nachocarballeda/gclass_amplifier/README.md

# gclass_amplifier
Diseño de un amplificador clase G para la materia Circuitos Electronicos 2. FIUBA
