nachocarballeda/gclass_amplifier/informe/caratula.tex

\begin{titlepage}

\thispagestyle{empty}

\begin{center}

\\[0.1cm]
\textsc{\universidad}\\[0.2cm]
\large{\textsc{\facultad}}\\[0.2cm]

\end{center}

\vfill

\begin{center}
\underline{\Large{\nombreMateria\, (\codigoMateria)}}
\end{center}

\vfill
\begin{center}

\end{center}
\vfill

\begin{center}
\Huge{\textsc{ \tituloTP }}\\[.5cm]
	\begin{figure}[H]
		\centering
		%\inclugraphics[width=.5\textwidth]{bessel}
	\end{figure}\HRule \\[0.1cm]
\Huge{\textbf{\descripcionTP}}\\[0.01cm]
\HRule\\[0.3cm]
\end{center}

\vfill

\begin{tabbing}
	FECHA: \today\\
\\
	INTEGRANTES:\hspace{-1cm}\=\+\hspace{1cm}\=\hspace{6cm}\=\\
% 		Gomez, Cristian	\>\>- \#89968\\
%			\>\footnotesize{$<$crisgvenezia@gmail.com$>$}\\
		Pollitzer, Ivan Gustavo	\>\>- \#22922\\
			\>\footnotesize{$<$igpollitzer@gmail.com$>$}\\
		Carballeda, Ignacio	\>\>- \#91646\\
			\>\footnotesize{$<$carballeda.ignacio@gmail.com$>$}\\
		Marques Rojo, Rui Alejandro\>\>- \#85748\\
			\>\footnotesize{$<$rui.rojo@gmail.com$>$}\\			

\end{tabbing}

\begin{flushleft} \large
\emph{Docentes:}\\[.2cm]
\end{flushleft}
\begin{tabbing}
\docentes\\[.5cm]
\end{tabbing}

\vfill

\hrule
\vspace{0.2cm}

\noindent\small{\codigoMateria\, --- \nombreMateria \hfill \facultad}

\end{titlepage}
