nachocarballeda/gclass_amplifier/informe/img/diagramabloque.pdf

Optimización
de recorrido
Inicio | Ruta actual
