nachocarballeda/gclass_amplifier/informe/avance/img/sim/distorsion-barrido.pdf

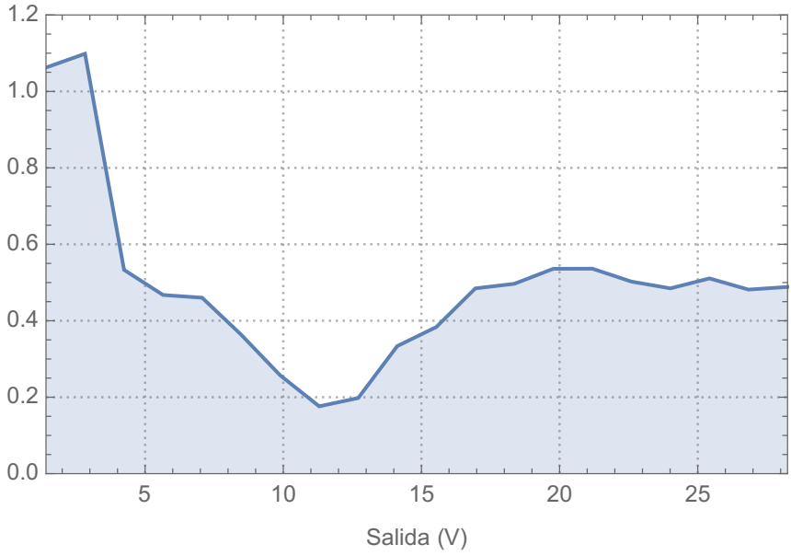
[picture p110: figure]
Salida

## THD (%)
