nachocarballeda/gclass_amplifier/informe/banco/amplificador.png

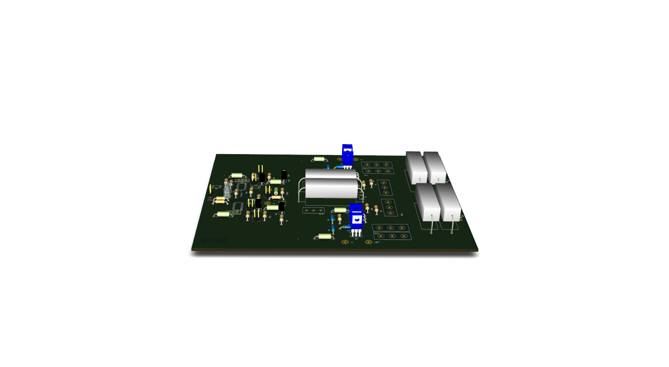
informe/banco/amplificador.png
