nachocarballeda/gclass_amplifier/informe/banco/fasttrack.jpg

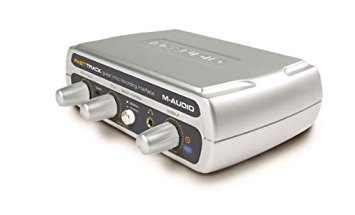
informe/banco/fasttrack.jpg
