nachocarballeda/gclass_amplifier/informe/banco/fuente.jpg

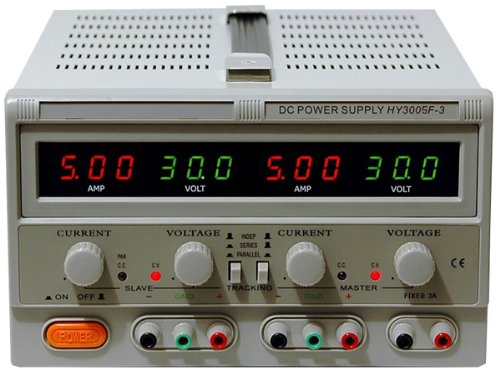
informe/banco/fuente.jpg
