nachocarballeda/gclass_amplifier/informe/banco/gen.jpg

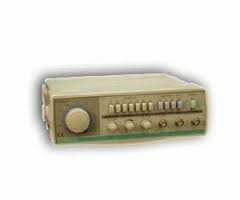
informe/banco/gen.jpg
