nachocarballeda/gclass_amplifier/informe/banco/mult-tip.png

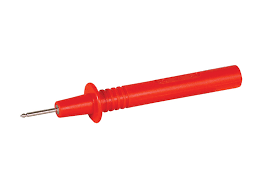
informe/banco/mult-tip.png
