nachocarballeda/gclass_amplifier/informe/banco/mult.jpg

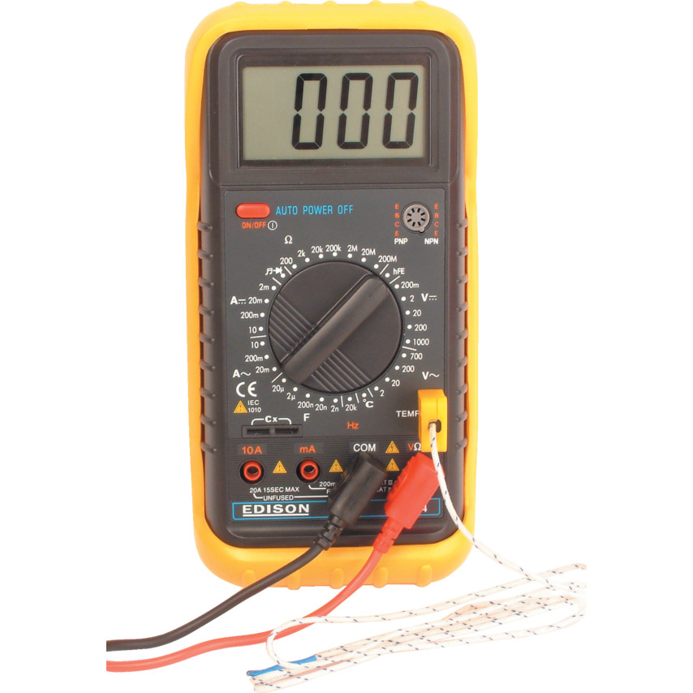
informe/banco/mult.jpg
