nachocarballeda/gclass_amplifier/informe/banco/osc-probe.jpg

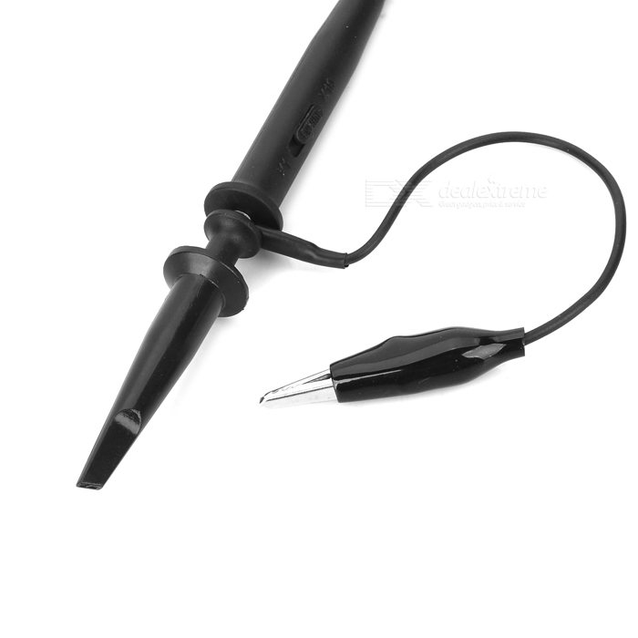
informe/banco/osc-probe.jpg
