nachocarballeda/gclass_amplifier/informe/banco/oscil-atten.jpg

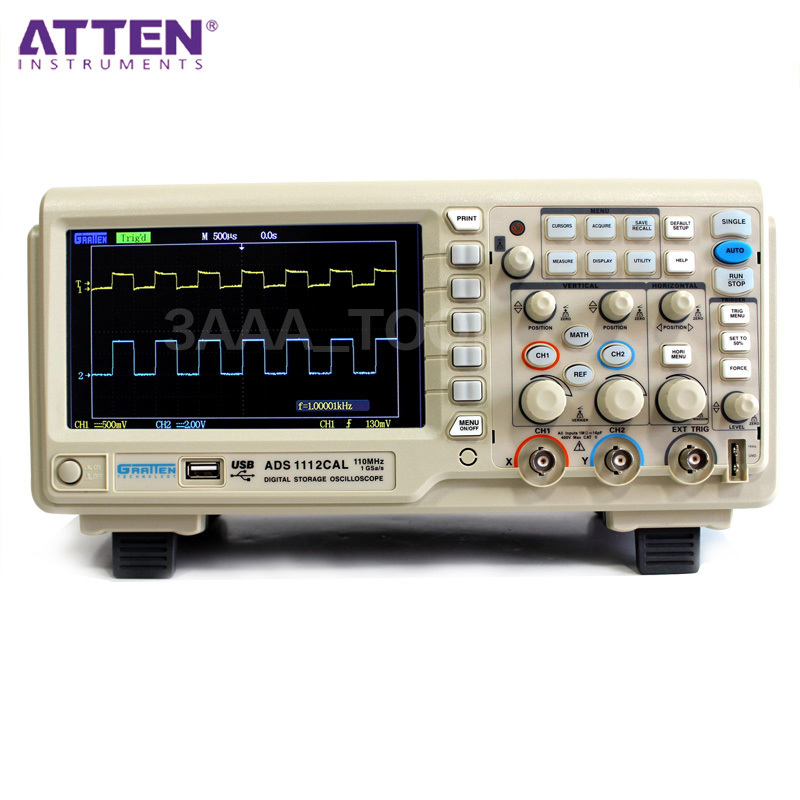
informe/banco/oscil-atten.jpg
