nachocarballeda/gclass_amplifier/informe/banco/osciloscopio.jpg

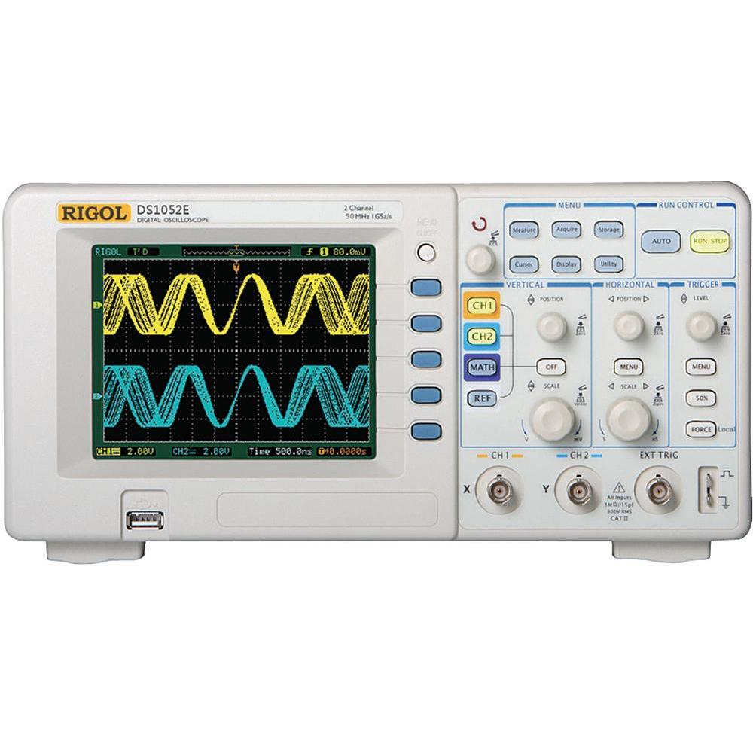
informe/banco/osciloscopio.jpg
