nachocarballeda/gclass_amplifier/informe/banco/pote.jpg

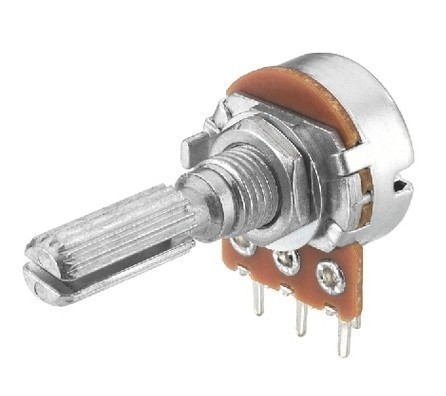
informe/banco/pote.jpg
