nachocarballeda/gclass_amplifier/informe/banco/res.jpg

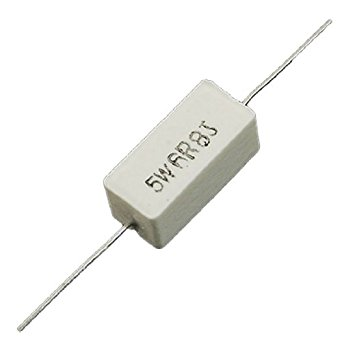
informe/banco/res.jpg
