nachocarballeda/gclass_amplifier/informe/banco/resS.JPG

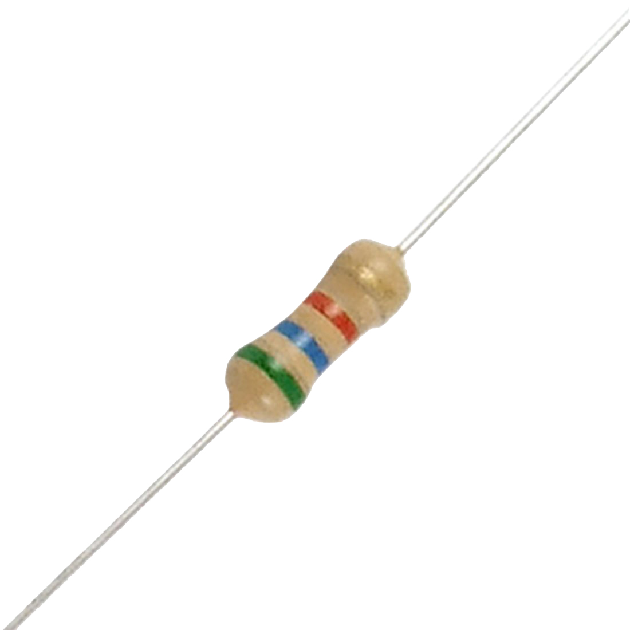
informe/banco/resS.JPG
