nachocarballeda/gclass_amplifier/informe/banco/tip2.jpeg

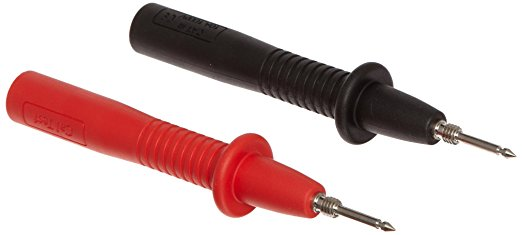
informe/banco/tip2.jpeg
