nachocarballeda/gclass_amplifier/informe/banco/transf.jpg

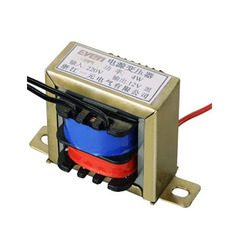
informe/banco/transf.jpg
