nachocarballeda/gclass_amplifier/informe/img/ampliA.png

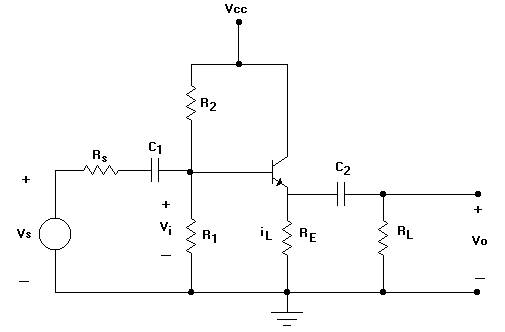
informe/img/ampliA.png
