nachocarballeda/gclass_amplifier/informe/img/ampliC.png

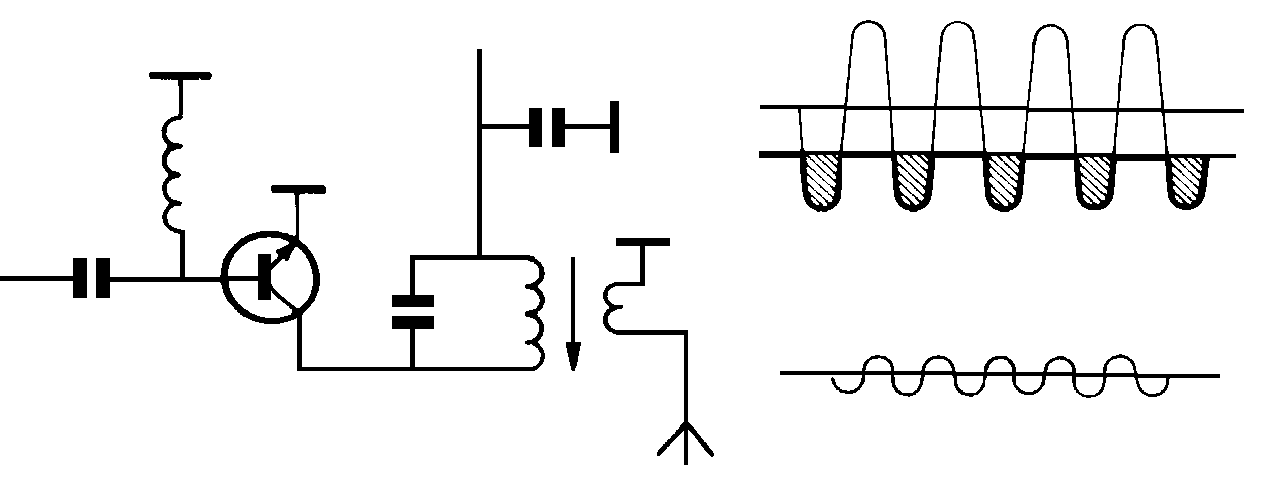
informe/img/ampliC.png
