nachocarballeda/gclass_amplifier/informe/img/ampliD.png

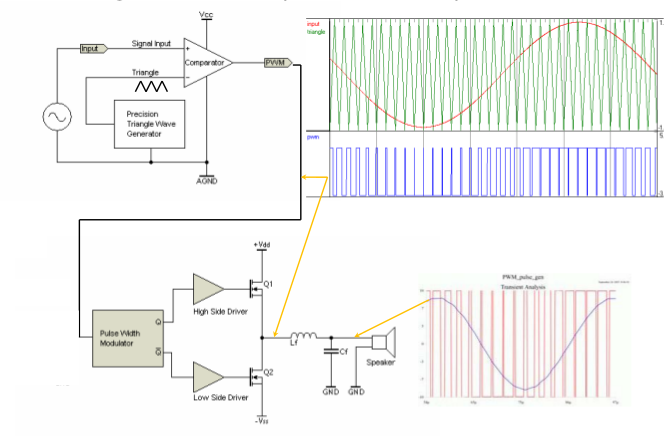
informe/img/ampliD.png
