nachocarballeda/gclass_amplifier/informe/img/circuito_propuesto.PNG

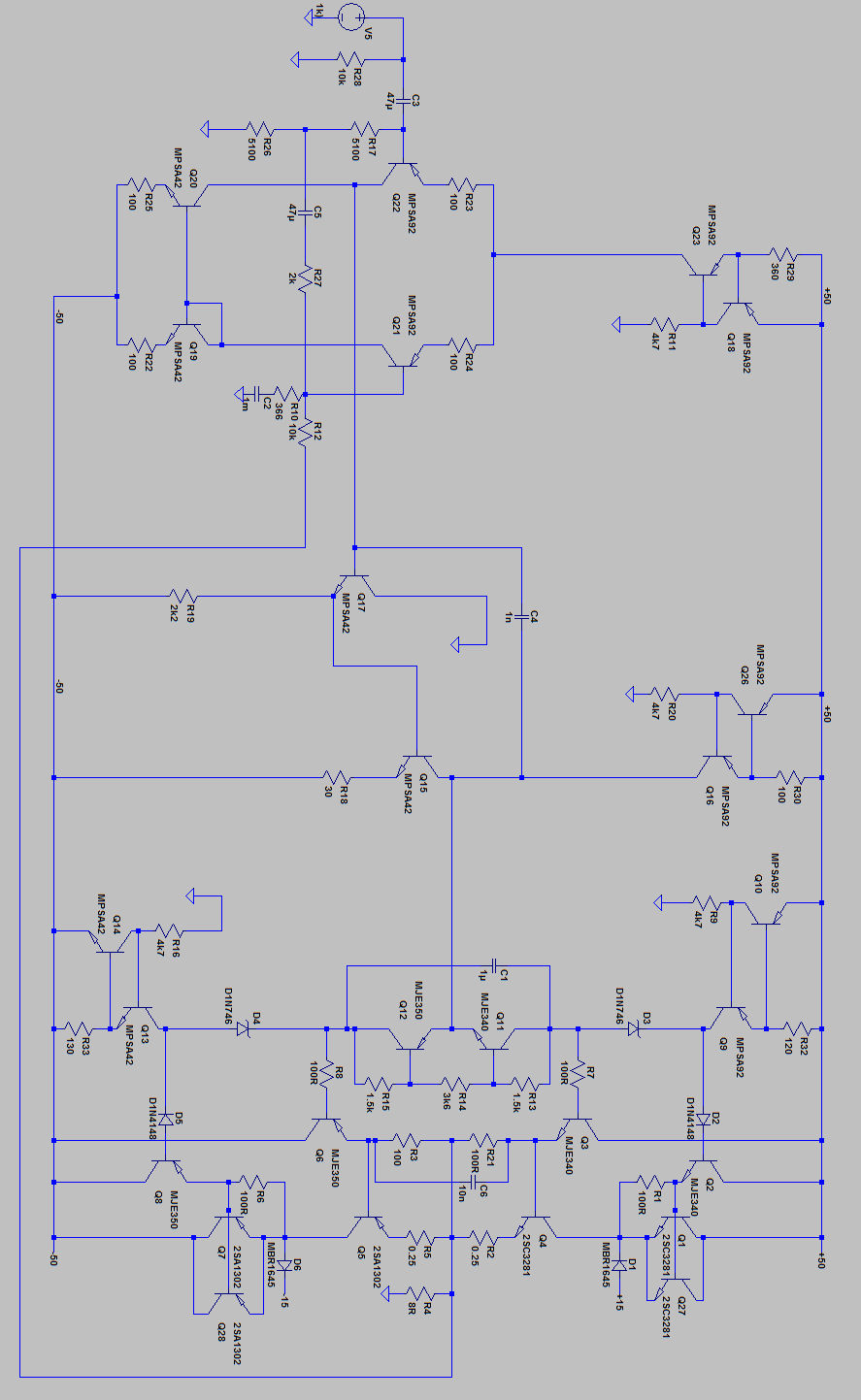
informe/img/circuito_propuesto.PNG
