nachocarballeda/gclass_amplifier/informe/img/fft.PNG

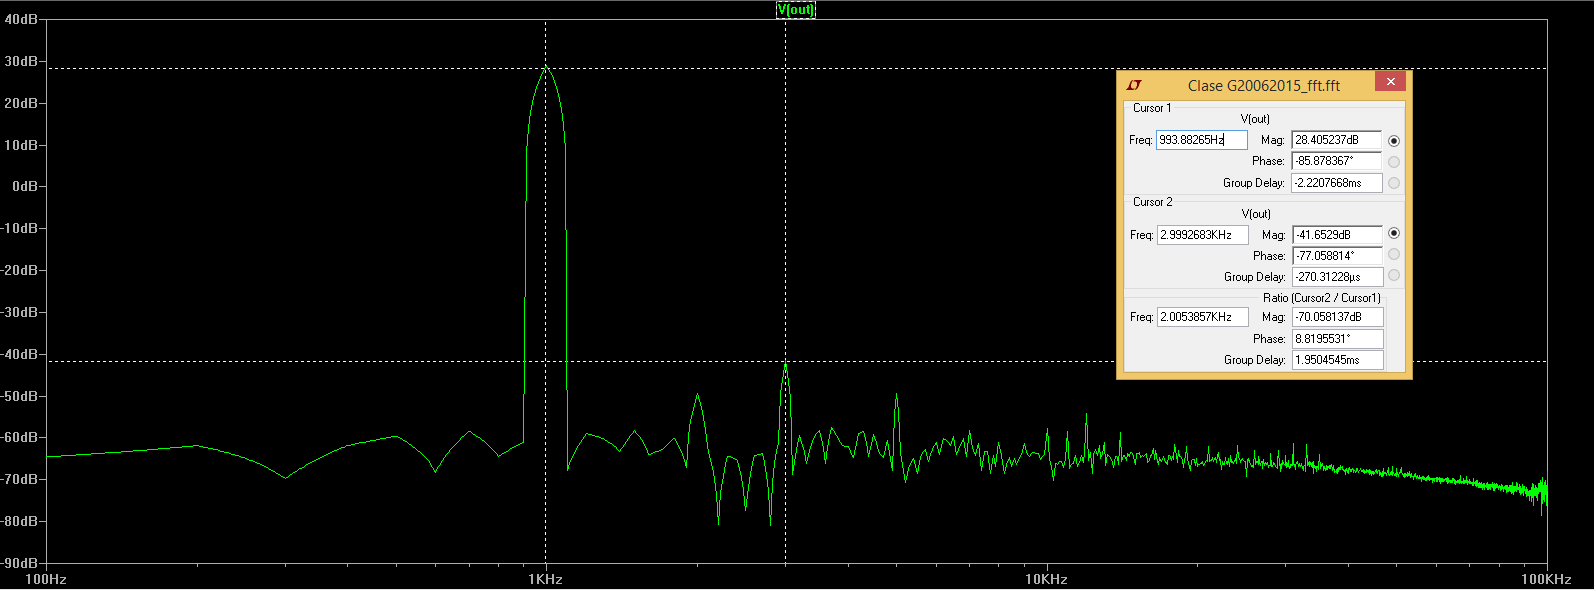
informe/img/fft.PNG
