nachocarballeda/gclass_amplifier/informe/img/img1.png

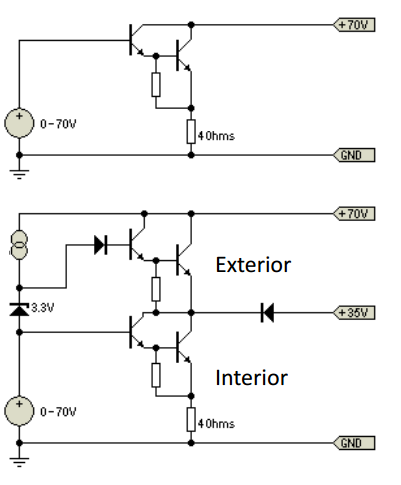
informe/img/img1.png
