nachocarballeda/gclass_amplifier/informe/img/img2.png

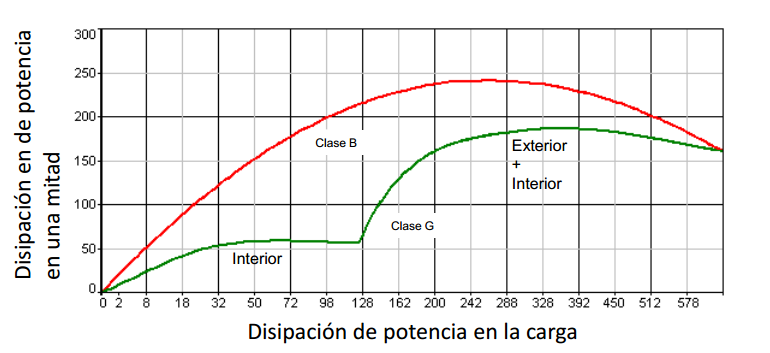
informe/img/img2.png
