nachocarballeda/gclass_amplifier/informe/img/mjes-power.png

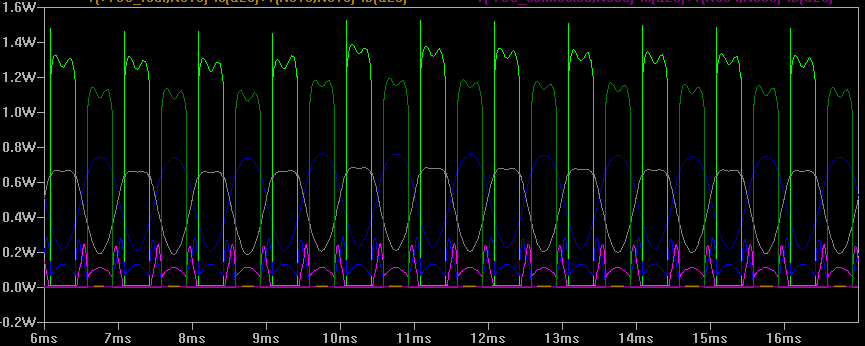
informe/img/mjes-power.png
