nachocarballeda/gclass_amplifier/informe/img/polarizacion.PNG

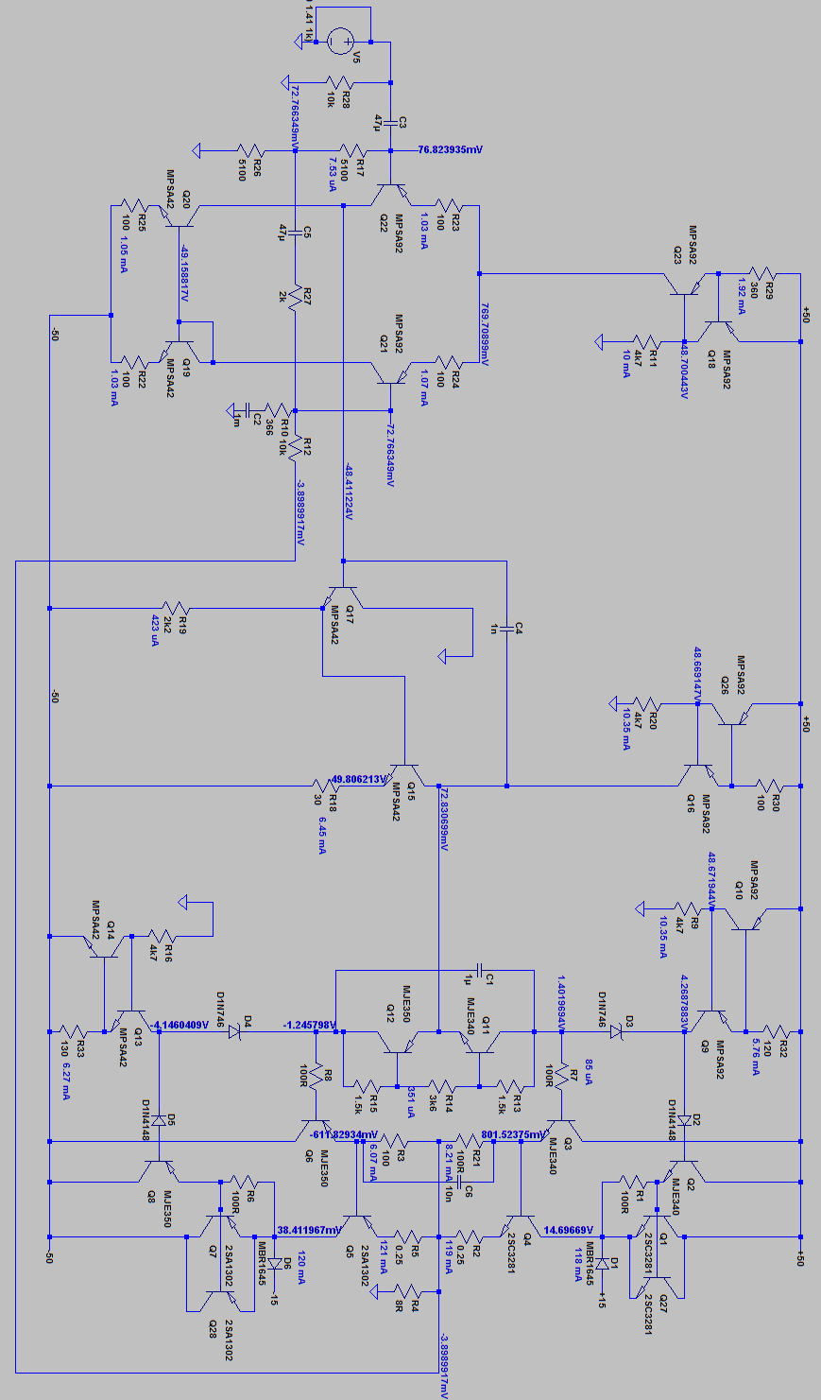
informe/img/polarizacion.PNG
