nachocarballeda/gclass_amplifier/informe/img/sim/circuito-doble-par-bode-10k.png

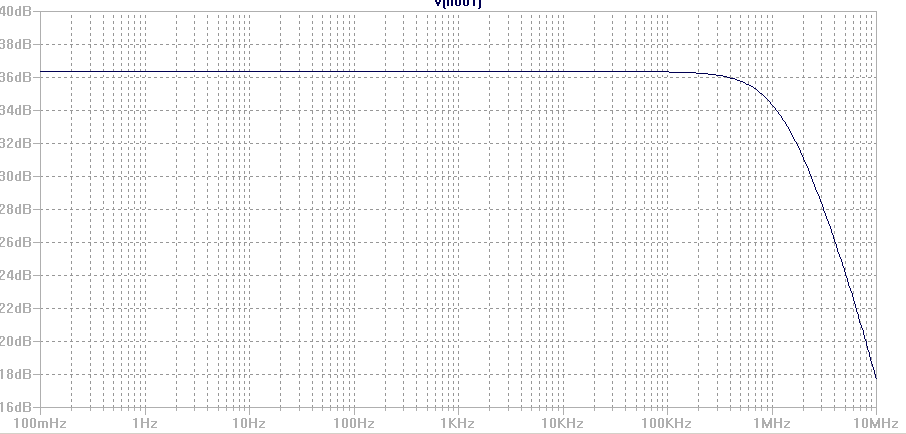
informe/img/sim/circuito-doble-par-bode-10k.png
