nachocarballeda/gclass_amplifier/informe/img/sim/circuito-par-cascode-bode-10k.png

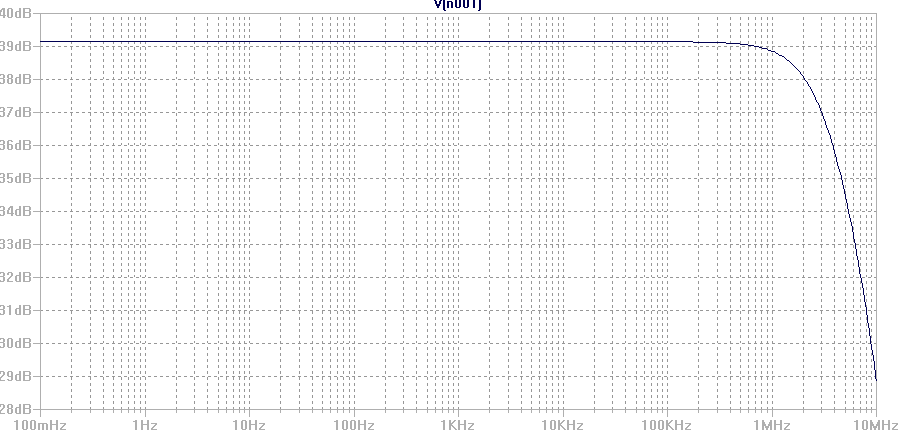
informe/img/sim/circuito-par-cascode-bode-10k.png
