nachocarballeda/gclass_amplifier/informe/img/sim/circuito-par-cascode.png

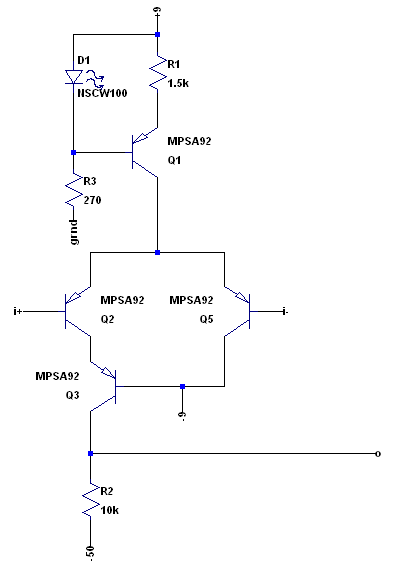
informe/img/sim/circuito-par-cascode.png
