nachocarballeda/gclass_amplifier/informe/img/sim/circuito-r_out.png

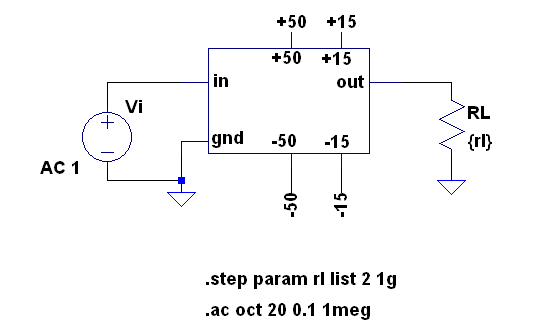
informe/img/sim/circuito-r_out.png
