nachocarballeda/gclass_amplifier/informe/img/slew_rate.PNG

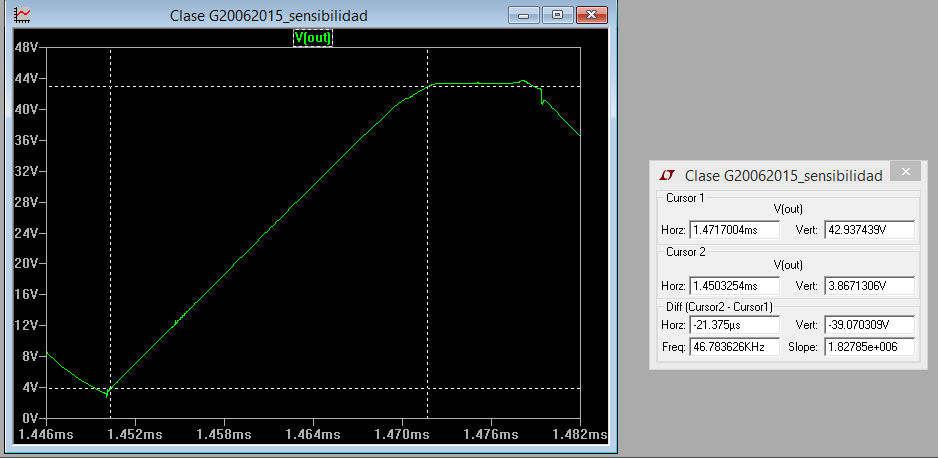
informe/img/slew_rate.PNG
