nachocarballeda/gclass_amplifier/informe/img/zd3.jpg

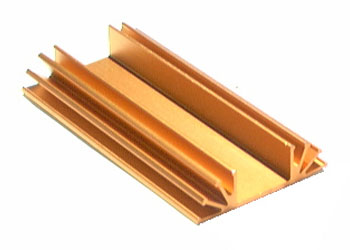
informe/img/zd3.jpg
