nachocarballeda/gclass_amplifier/informe/mediciones/includes/slew.jpg

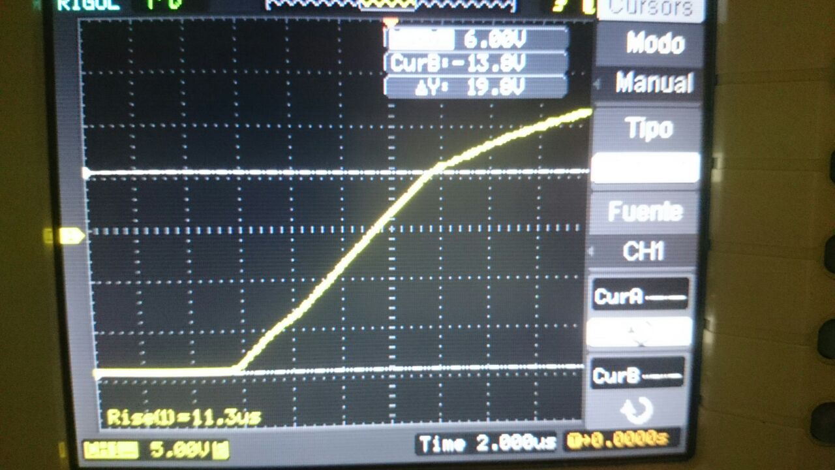
informe/mediciones/includes/slew.jpg
