nachocarballeda/gclass_amplifier/(list of files, cad)

Other CAD files:
pcb/PCB_3d_model.fcstd
