nachocarballeda/gclass_amplifier/sims/pruebas/pruebas-rui/plots/test.txt

Freq.	-V(n013)/I(V5)
1.00000000000000e-001	(9.09516936097004e+001dB,-7.36975448381585e+001°)
1.03526492384138e-001	(9.06752023476581e+001dB,-7.31548731468580e+001°)
1.07177346253629e-001	(9.04003183900117e+001dB,-7.25963432233475e+001°)
1.10956947206785e-001	(9.01271363469511e+001dB,-7.20217111976893e+001°)
1.14869835499704e-001	(8.98557549782021e+001dB,-7.14307518212159e+001°)
1.18920711500272e-001	(8.95862771869094e+001dB,-7.08232609541542e+001°)
1.23114441334492e-001	(8.93188099845264e+001dB,-7.01990581782132e+001°)
1.27456062731926e-001	(8.90534644232138e+001dB,-6.95579895235196e+001°)
1.31950791077289e-001	(8.87903554921842e+001dB,-6.88999302959567e+001°)
1.36604025675440e-001	(8.85296019744376e+001dB,-6.82247879873335e+001°)
1.41421356237310e-001	(8.82713262604010e+001dB,-6.75325052469033e+001°)
1.46408569594563e-001	(8.80156541151512e+001dB,-6.68230628886239e+001°)
1.51571656651040e-001	(8.77627143961546e+001dB,-6.60964829042705e+001°)
1.56916819579350e-001	(8.75126387188291e+001dB,-6.53528314481742e+001°)
1.62450479271247e-001	(8.72655610677190e+001dB,-6.45922217550635e+001°)
1.68179283050743e-001	(8.70216173516894e+001dB,-6.38148169483837e+001°)
1.74110112659225e-001	(8.67809449022943e+001dB,-6.30208326926917e+001°)
1.80250092522166e-001	(8.65436819153490e+001dB,-6.22105396404686e+001°)
1.86606598307362e-001	(8.63099668367490e+001dB,-6.13842656211126e+001°)
1.93187265784969e-001	(8.60799376946976e+001dB,-6.05423975181923e+001°)
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
9.30774334994442e+005	(6.43486961676853e+001dB,-1.06168323063527e+002°)
9.63598021031530e+005	(6.38134784302734e+001dB,-1.05341768368432e+002°)
9.97579231856909e+005	(6.32878423705015e+001dB,-1.04423265743424e+002°)
1.00000000000000e+006	(6.32514538110982e+001dB,-1.04355679441212e+002°)
