nachocarballeda/gclass_amplifier/(threads)

Thread 4 (2015-12-06):

La distorsión daba para la mierda

anojo, 2015-12-06:
Bueno, era culpa mía nomás.

Simular pocos períodos jode la simulación de la distorsión, pero también erra si le ponés un timestep máximo alto (o lo dejás en automático). Alguno de uds había sugerido eso el otro día. Bueno, tengo el agrado de avisarles que la distorsión volvió a estar en el orden de 0.05%.

Igual todavía hay que mejorarla.

Closed 2015-12-12.

Thread 5 (2015-12-06):

Especificaciones

anojo, 2015-12-06:
Fede dijo que hay que especificar también un par de cosas más. ¿Qué valores les parecen? Por ahora mando esto:

* Ancho de banda de potencia: >30kHz
* Ancho de banda: 10Hz-30kHz
* Factor de amortiguamiento: >200

Fede no dijo pero seguramente haya que especificar igual:

* Margen de  fase
* Margen de ganancia
* Eficiencia
* SNR
* Otros tipos de distorsión que no sean THD?

anojo, 2015-12-09:
¡Especificar SNR y eficiencia!

Closed 2015-12-12.

Thread 7 (2015-12-09):

Cambios del circuito

anojo, 2015-12-09:
¿Qué mierda falta cambiar así rápido paralelizamos las tareas?

* Capaz el bootstrap
* Lo que mandó Fede para la primera etapa
* ¿Cargas activas vs resistencia en el VAS?
* ¿Fuente conmutada diseñada?

anojo, 2015-12-09:
Modelos de transistor de etapa de entrada??? Chequear early

Closed 2015-12-12.

Thread 10 (2015-12-14):

Chamullos que puede estar bueno tirar en el informe

anojo, 2015-12-14:
Tiremos en este issue esas ideas aisladas. Ejemplo.
- Importancia de la tensión de early en los transistores del VAS, porque hacen de carga activa el uno del otro

anojo, 2015-12-14:
* Importancia del beta de todos los transistores del VAS para que reflejen mucha resistencia y se fije mejor la tensión. Principalmente del del buffer, porque si el del EC es muy grande, la corriente de polarización del buffer se vuelve porquería. Pero, no veo que eso sea un problema, no sé. ¿Capaz estás dejando nodos de alta impedancia y eso jode al ruido? Tengo bastante poco fresco el tema del ruido

anojo, 2015-12-14:
Compensación. Algún chamullo del cero del realimentador y de Miller, y del compromiso con el slew rate. El slew rate todavía no lo entiendo bien, algún día miraré de vuelta esa clase de Bertuccio

anojo, 2015-12-14:
La R_E del EC del VAS. Realimentación para estabilizar, blabla, pero no muy alta porque, además de perder amplificación, roba excursión a la salida

anojo, 2015-12-14:
A la salida, anchas, gordas y cortas las cosas, por las altas corrientes, y por la baja resistencia de salida (gracias a la realimentación) que hay que mantener para que se mantenga un buen factor de amortiguamiente.

Closed 2017-11-03.

Thread 11 (2015-12-14):

Presets

anojo, 2015-12-14:
¿En las resistencias de los leds? Polarizan todo el circuito

nachocarballeda, 2015-12-17:
??? no entendi

anojo, 2015-12-20:
@nachocarballeda Iván me había preguntado dónde podía convenir poner presets para las resistencias de valor sensible. Después dijo que quede para después. Supuse que en las resistencias en los leds, que regulan las fuentes de corriente de la 1era etapa, pero no está definid.

anojo, 2015-12-22:
Me habían comentado que había pines en el PCB para probar cosas y que les viniero bárbaro el semestre pasado. ¿Dónde quedan esos pines en el circuito?

Closed 2017-11-03.

Thread 12 (2015-12-14):

Zobel

anojo, 2015-12-14:
Parece que sí era importante.
Según Douglas, 10 ohms y 0.1uF va bien siempre y fuck it.

anojo, 2015-12-16:
La escribe "ZoEbel" en el mail

igpollitzer, 2015-12-16:
Agregué la red de Zobel. Dejo este inconveniente abierto, por si quieren dejarlo hasta que lo agreguen en el informe. Sino, cierrenlo.

anojo, 2015-12-16:
Claro que queda abierto. No le consultamos a Fede, no lo agregamos en el circuito.

anojo, 2015-12-16:
Además, por loq ue veo en el circuito del clase G del Douglas, además de esa RC tiene un RL paralelo a la salida

anojo, 2015-12-16:
Aparentemente, es el RC lo que se llama Zobel. Y el LR es para "aislar al amplificador de capacidad de carga". "Un componente de 15-20 vueltas de diámetro 1 pultada debería funcionar bien. El valor de la inductancia no es para nada crítico para la estabilidad"

anojo, 2015-12-16:
El inductor tiene que ser de aire para tener menos distorsión. Los valores de L suelen andar en 1-7uH.

Closed 2015-12-22.

Thread 13 (2015-12-14):

Protecciones

anojo, 2015-12-14:
No van en el informe de aprobación. Pero, ¿cuáles ponemos?
- Contra mucha carga => mucha corriente a la salida.

anojo, 2015-12-20:
Ojo que no hagan bolsa la distorsión

Closed 2017-11-03.

Thread 15 (2015-12-14):

Cálculos y simulación de ganancia y polarización de cada etapa

anojo, 2015-12-14:
Paja. Será bien resumido. "anojo" puede hacer el chamullo de las primeras 2 etapas, pero la tercera no.

anojo, 2015-12-20:
Lo principal está. Faltaría un poco, en particular de la 3ra etapa

Closed 2017-11-03.

Thread 16 (2015-12-14):

Cálculo y justificación de las decisiones de diseño

anojo, 2015-12-14:
Valores de componentes, tipos, tecnologías, subcircuitos, lablab.

nachocarballeda, 2015-12-17:
esto ya esta.. ¿le mando los datasheets de los "subcircuitos"  ??

anojo, 2015-12-17:
Meter los datasheets en el informe de avance sería demasiado,  jaja

nachocarballeda, 2015-12-17:
entonces cerramos esto?

anojo, 2015-12-17:
yo no lo cerraría, me parece que es uno de esos puntos donde mienrtas más mejor. Dejémoslo para lo último.

anojo, 2015-12-20:
Faltan, al menos, cuestiones de la etapa de salida (¿para qué es ese capacitorr? Una versus otra opción respecto de las resistencias en los emisores de los drivers de la parte interna. Chamullo diodo schohcsocohty, ...)

Closed 2015-12-22.

Thread 17 (2015-12-14):

Lista de componentes

anojo, 2015-12-14:
Tabla con

Nombre en el esquemático |  valor/modelo  | Tolerancia (?) | Potencia (?) | Tecnología/whatever

anojo, 2015-12-16:
Aclarar en dónde se usa SMD. Ver si hace falta incluir tooodo, disipadores etc

anojo, 2015-12-17:
¿Tolerancias?

nachocarballeda, 2015-12-17:
listo,agregadas tolerancias no entran mas columnas.

Closed 2015-12-17.

Thread 21 (2015-12-14):

Mejora mult de vbe

anojo, 2015-12-14:
Agregar resistores en los colectores, y sacar la tensión de ahí para que sea más plano el multiplicador

anojo, 2015-12-20:
Ver balance eficiencia-distorsión. También, frase sacada de contexto del Douglas en la parte de etapa de salida, la distorsión en modo AB es peor que en A y que en B. Huh??

Closed 2017-11-03.

Thread 9 (2015-12-14):

[PCB] Falta conector de entrada

nachocarballeda, 2015-12-14:
Necesitamos un buen plug hembra con carcaza anti ruido para la entrada de nuestro amplificador.

nachocarballeda, 2015-12-16:
Este issue nos chupa un huevo por ahora :D

Closed 2015-12-16.

Thread 23 (2015-12-16):

Especificaciones: Slew Rate

anojo, 2015-12-16:
"El valor de SR es apenas mayor que el mínimo necesario, respecto del que garantiza un ancho de banda de potencia de 20KHz con Vo pico 50V."

anojo, 2015-12-16:
¿por qué 50V si la máx excursión es 40V?

anojo, 2015-12-16:
¿Y porqué 20kHz si especificamos 30kHz?

anojo, 2015-12-16:
Nuestro límite, con 30kHz, y 40V, es de 7.5 V/us. Si tomamos los 50V que soñó Fede, queda 9.4V/us. La simulación nos da que tenemos 20V/us. Es gratis entonces subir la especificación hasta ese punto.

anojo, 2015-12-17:
Le puse 15 y chamullo

Closed 2015-12-17.

Thread 24 (2015-12-16):

Diseño general, etapa de salida

anojo, 2015-12-16:
"En la página 4 no hace falta hablar del clase D ya que eligieron la clase G."

anojo, 2015-12-16:
Ok, lo sacamos, pero. Ellos nos dijeron que pusiéramos cómo consideramos otras opciones de diseño dados los requerimientos de usuario.

Closed 2015-12-16.

Thread 25 (2015-12-16):

Resistencias de emisor

anojo, 2015-12-16:
Aclaración al circuito que tienen: conviene poner una resistencia entre el emisor de Q13 y +50V, de manera que el seguidor le presente una menor impedancia al emisor común. Es decir, se necesita que el Q13 tenga una mayor corriente que Q14. Lo mismo ocurre con el Q10 y Q9.

anojo, 2015-12-16:
Que necesita mayor corriente que la de Q14/beta, lo "sospechaba" aunque no entendía (y por eso hice el cambio igual, ya que lo había sugerido el propio Fede en la última reunión lo de desaparecer esas resistencias"). Pero, ¿mayor que Q14? ¿Seguro, por qué?

Closed 2015-12-17.

Thread 26 (2015-12-16):

Punto #9: mail Fede

anojo, 2015-12-16:
En la etapa de salida, cuando agregan las resistencias que les mencioné, no era para evitar el embalamiento térmico sino para que circule la mitad de corriente por cada transistor ya que Q11 y Q12 tienen un propósito.

Closed 2015-12-17.

Thread 27 (2015-12-16):

Punto #10: mail Fede

anojo, 2015-12-16:
Fíjense de revisar la Fig.4, ya que la distorsión no tiende a cero cuando baja la alimentación.

anojo, 2015-12-16:
Supongo que cuando dijo alimentación se refería a la tensión pico de salida. Y tiene razón, no debería achicarse tanto, con el crossovor y eso, al contrario. Yo lo reviso

Closed 2015-12-17.

Thread 31 (2015-12-16):

Punto #2: mail Fede

anojo, 2015-12-16:
Los análisis que hagan, deberían ser en base a los antecedentes que encontraron, es decir: plantear bloques o soluciones en base a circuitos modelos. También es conveniente que expliquen qué tipo de realimentación utilizan, es decir, qué se suma y qué se muestrea. Analicen el circuito como si fuera un Op.Amp. realimentado, viendo las Zin, las Zo, etc, todo tal cual lo vieron en la 1era parte de la materia, incluído el SR, la compensación etc.

anojo, 2015-12-16:
Lo desgloso en sus subpuntos

Closed 2015-12-16.

Thread 32 (2015-12-16):

Especificaciones: sensibilidad

anojo, 2015-12-16:
La sensibilidad debe especificarse a qué potencia - carga específica (pág 3)

anojo, 2015-12-16:
¿No se entiende que si especificamos que el ampli trabaja con 8 ohms, la sensibilidad y todo lo demás, por defecto, es con 8 orms de carga? Sigh

igpollitzer, 2015-12-16:
Suspirás en inglés? Es lo que hay, viejo, respetar la nomenclatura.

anojo, 2015-12-16:
Bueno, cambio 1V RMS a 1V RMS @ 8\Omega.  ¿Valdrá la pena también especificar en corto, o a 2/4 ohms?

Closed 2015-12-17.

Thread 33 (2015-12-16):

Realimentación

anojo, 2015-12-16:
Poner qué tipo de realimentación utilizan, es decir, qué se suma y qué se muestrea

anojo, 2015-12-16:
Ok, esto es factible. Mirar el circuito, ver todas las realimentaciones, globales y locales que se encuentren, que estén mencionadas ena lgna  parte del informe, y donde lo estén, que se mencione si son serie-paralelo (sumo tensión muestreo tensión), serie-serie (...), etc.

igpollitzer, 2015-12-16:
Yo asumo que la respuesta, es la del issue siguiente.

Closed 2015-12-17.

Thread 34 (2015-12-16):

Modelo como op-amp realimentado

anojo, 2015-12-16:
Analicen el circuito como si fuera un Op.Amp. realimentado, viendo las Zin, las Zo, etc, todo tal cual lo vieron en la 1era parte de la materia, incluído el SR, la compensación etc.

anojo, 2015-12-16:
Ok, no pusimos ningún diagrama con el triangulito realimentado. Pero slew rate, compensación, no estoy seguro de lo que quiere. ¿Ustedes?

igpollitzer, 2015-12-16:
asumo que quiere que hagamos el triangulito, con el cuadrado de realimentación abajo, midiendo tensión y sumando tensión (paralelo/serie) eso modifica las impedancias de entrada y salida. No se que es lo que quiere con el SR y la compensación, salvo que sea hacer Ivas x Cmiller.

anojo, 2015-12-16:
@igpollitzer pero el nodo de Miller está adentro del opamp, no veo cómo se puede mencionar con ese modelo

nachocarballeda, 2015-12-16:
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
Bob Cordell  - Designing Audio Power Amplifiers

igpollitzer, 2015-12-17:
Bueno, yo creo que esto ya está terminado. Hice el dibujito del opamp realimentado, hice el gráfico de Bode compensado, y el cálculo del Slew Rate. Todo Bertu-Style.

Closed 2015-12-18.

Thread 35 (2015-12-16):

Punto #2.5: mail Fede

anojo, 2015-12-16:
Los análisis que hagan, deberían ser en base a los antecedentes que encontraron, es decir: plantear bloques o soluciones en base a circuitos modelos.

anojo, 2015-12-16:
Huh?

nachocarballeda, 2015-12-16:
Creo que quiere decir que si usas un ampli doble diferencial le expliques porque (esto se hizo), y 2doble le 2Vbe le expliques porque , y todo asi diciendo de donde sacaste la idea.

Closed 2015-12-18.

Thread 36 (2015-12-16):

Cosa general pero "NO MENOS IMPORTANTE"

anojo, 2015-12-16:
Antes que nada, y no menos importante, traten de explicar el Informe como si se lo fueran a dar a alguien que lo quiere armar. Es decir, explicando por qué está tal etapa y/o componente, con su respectivo valor, pero de forma concreta.

Closed 2017-11-03.

Thread 38 (2015-12-17):

Antecedentes

anojo, 2015-12-17:
Ok, pero agreguen circuitos, notas de aplicación y otros esquemas demostrando que buscaron antecedentes de un Amp. Clase G

nachocarballeda, 2015-12-17:
Ok, voy a agregar el clase G del Douglas Self y buscar algun comercial

anojo, 2015-12-17:
El "buscar algún comercial" quedó inconcluso, ¿no?

Closed 2017-11-03.

Thread 40 (2015-12-20):

Qué transistores para la 2da etapa

anojo, 2015-12-20:
¿Los que están u otros? Los que están, según los modelos de LTSpice, tiene la desventaja de que
- No son muy simétricos entre sí los NPN de los PNP
- Tienen  tensión de Early baja y por eso son "mala carga" el uno del otro. Esto sólo importaría para los EC. Anojo tiene que simular para saber cuánto importa.
- Quizá, un beta mejor estabilizaría un poco más la polarización. No me suena que esto sea importante.

nachocarballeda, 2016-03-15:
Por ahora en la segundo etapa tenemos MPSA42 (NPN) y MPSA92 (PNP)
No entiendo eso de que "no son muy simetricos" , entiendo que uno es el complemento del otro.
El VCE es 300V  en ambos, ¿esto es poco?

Closed 2017-11-03.

Thread 41 (2015-12-20):

Mejorar PCB

anojo, 2015-12-20:

anojo, 2015-12-22:
¿Cómo se arma posta el tema de las redes de salida, zobel y la otra, con el inductor loco de 1 pulgada de diámetro?

nachocarballeda, 2015-12-22:
@anojo Con alambre, lo dice en el Douglas S.

anojo, 2015-12-22:
@nachocarballeda O sea, nada que ver con el PCB, ¿no?

Closed 2017-11-03.

Thread 42 (2015-12-20):

¿Oscilación en el semiciclo?

anojo, 2015-12-20:
No parece que nos pase en nuestro circuito, pero sí en alguna de las pruebas que hicimos. Cuando aparece, sólo aparece cuando simulás bien lento. Tiene que ver con compensaciones en la tercera etapa, cosas mal compensadas para ciertas amplitudes en cierto semiciclo. No sé cómo se probaría bien bien. Sería una buena consulta a Bertuccio por mail. Probé algo que más o menos funciona, creo, pero no sé cuán bien está: agregué una fuente de "offset" en serie con Rin de 10k, y otra de "offset*28.2..." en serie con los 10k del realimentador. Después, haciendo bodes para distintos "offsets" se ven cosas interesantes y, efectivamente, mostraba que estaba mal compensado en el semiciclo negativo en un caso donde oscilaba.

anojo, 2015-12-22:
Al menos meterlo en el informe. Consultar sobre cómo simular, etc

Closed 2017-11-03.

Thread 44 (2015-12-22):

Modelos transistores 1era etapa

anojo, 2015-12-22:
Encontrar/inventar modelo de transistor para la 1era etapa. Si lo mejor que podés encontrar en un subcircuito, y no sabés cómo hacerlo funcionar en ltspice avisá, que para mi fue prueba y error

nachocarballeda, 2016-02-12:
Los transistores a utilizar en la etapa de entrada son
MMPQ2907A (PNP)
MMPQ2222A (NPN)

Spice Model [http://hep.fi.infn.it/PAMELA/pdf/FFB2907A.pdf]
PNP (Is=650.6E-18 Xti=3 Eg=1.11 Vaf=115.7 Bf=231.7 Ne=1.829 Ise=54.81f Ikf=1.079 Xtb=1.5 Br=3.563 Nc=2
Isc=0 Ikr=0 Rc=.715 Cjc=14.76p Mjc=.5383 Vjc=.75 Fc=.5 Cje=19.82p Mje=.3357 Vje=.75 Tr=111.3n Tf=603.7p
Itf=.65 Vtf=5 Xtf=1.7 Rb=10)

Spice Model [http://www.farnell.com/datasheets/172298.pdf]
NPN (Is=14.34f Xti=3 Eg=1.11 Vaf=74.03 Bf=255.9 Ne=1.307 Ise=14.34f Ikf=.2847 Xtb=1.5 Br=6.092 Nc=2 Isc=0
Ikr=0 Rc=1 Cjc=7.306p Mjc=.3416 Vjc=.75 Fc=.5 Cje=22.01p Mje=.377 Vje=.75 Tr=46.91n Tf=411.1p Itf=.6
Vtf=1.7 Xtf=3 Rb=10)

nachocarballeda, 2016-03-15:
Done.

Closed 2016-03-15.

Thread 45 (2015-12-22):

Análisis etapa de salida

anojo, 2015-12-22:
Ver en el Douglas u otros lados, para qué está ese capacitor en a la etapa de salida. También, si había alternativas respecto de otras cositas, como esas resistencias entre los emisores de los drivers internos (en la parte de "etapa de salida" del clase B del libro creo que había cosas). Ir leyendo eso y chamullando en el informe, sobre para qué está cada cosa, y cambiando el circuito si algo resulta ser indefendiblemente mejor. Chamullo diodo Schotscscsy... Lo que se vaya pensando, se anota así ya va al informe.

anojo, 2015-12-22:
(Anojo tb va a ir dando una mano en estas cosas)

anojo, 2015-12-22:
¿Douglas dice que AB distorsiona más que B? Huh?

Closed 2017-11-03.

Thread 47 (2015-12-22):

R_out y amortiguamiento

anojo, 2015-12-22:
Ver R_out teniendo en cuenta el RL de la salida, y si es necesario la posible R serie del L y los cables.

anojo, 2015-12-22:
Esto queda para después, no es necesario para empezar a armar creo. A menos que el factor de amortiguamiento quede muy choto, pero no creo, qué se yo

Closed 2017-11-03.
