nachocarballeda/gclass_amplifier/informe/export_kicad.pdf

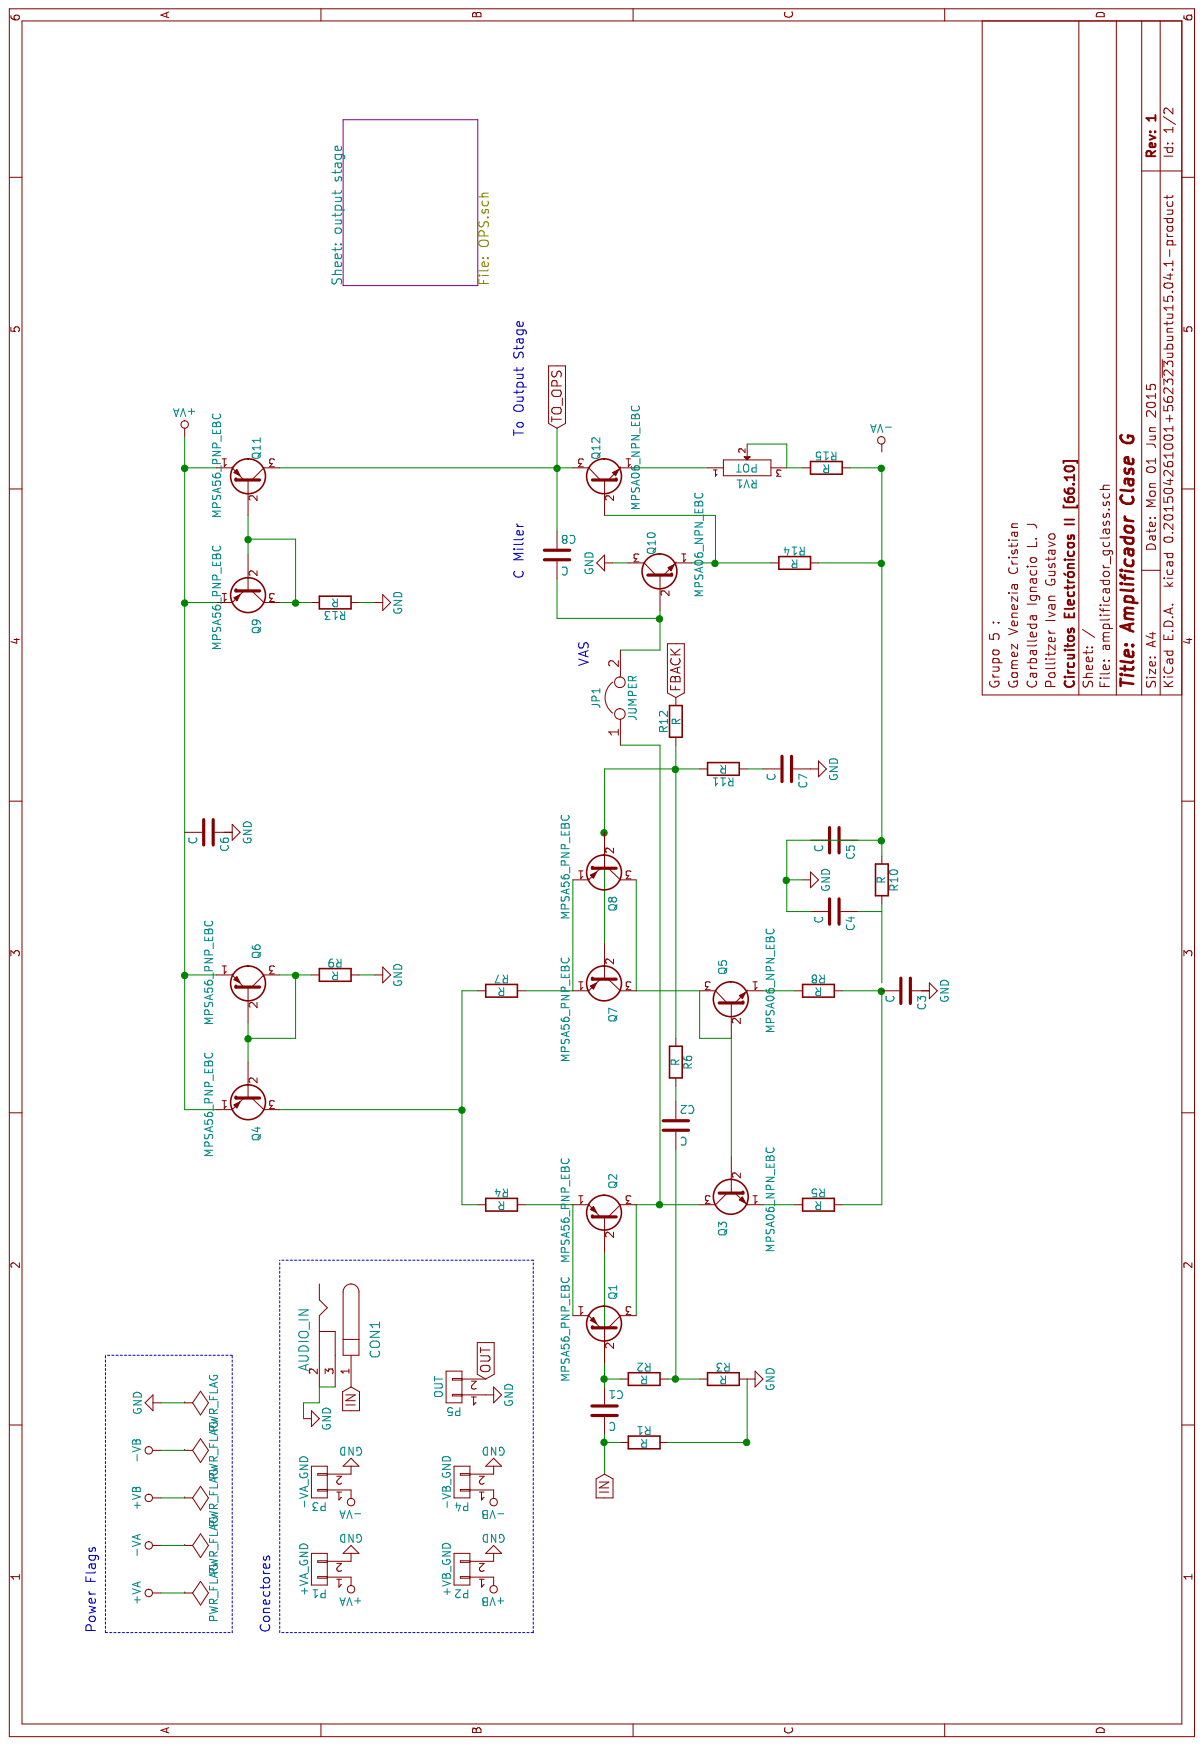
[picture p153: page 1]

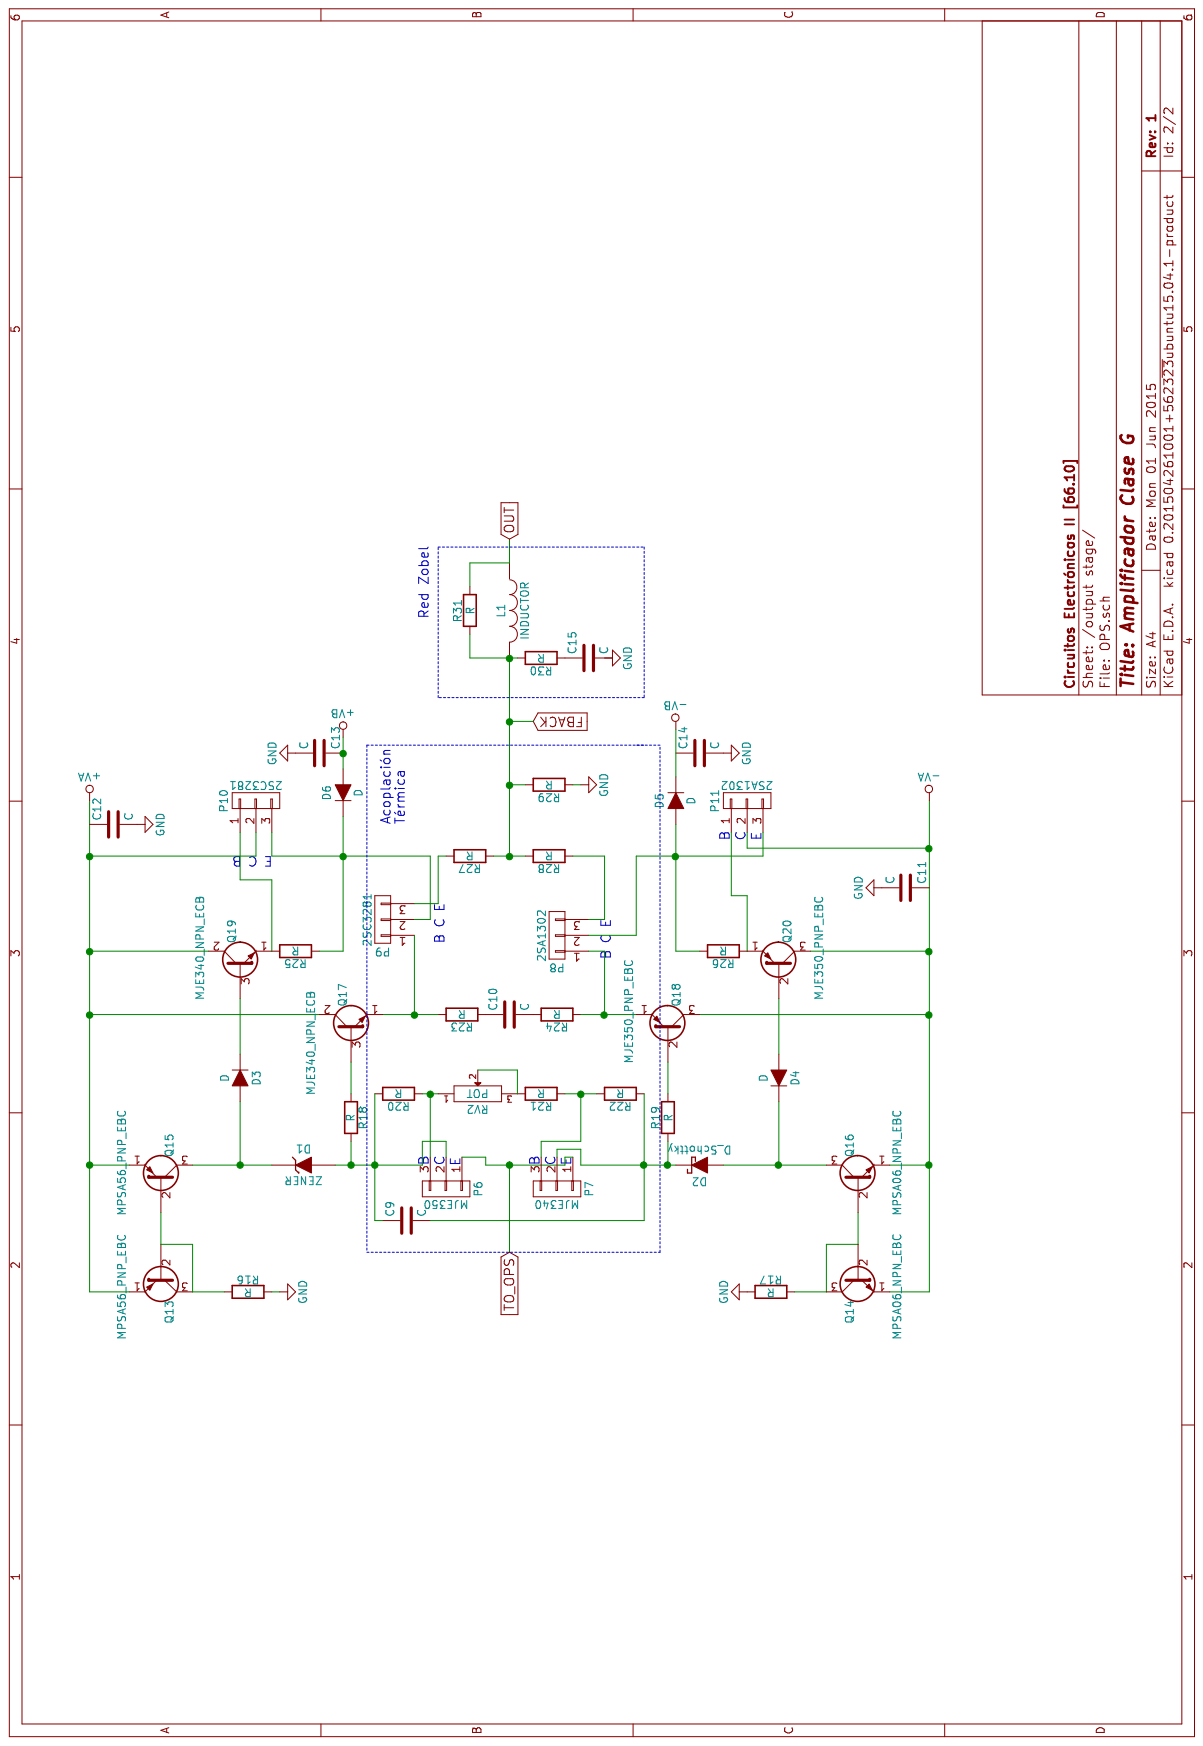
[picture p154: page 2]
