nachocarballeda/gclass_amplifier/informe/img/bodecompensado.pdf

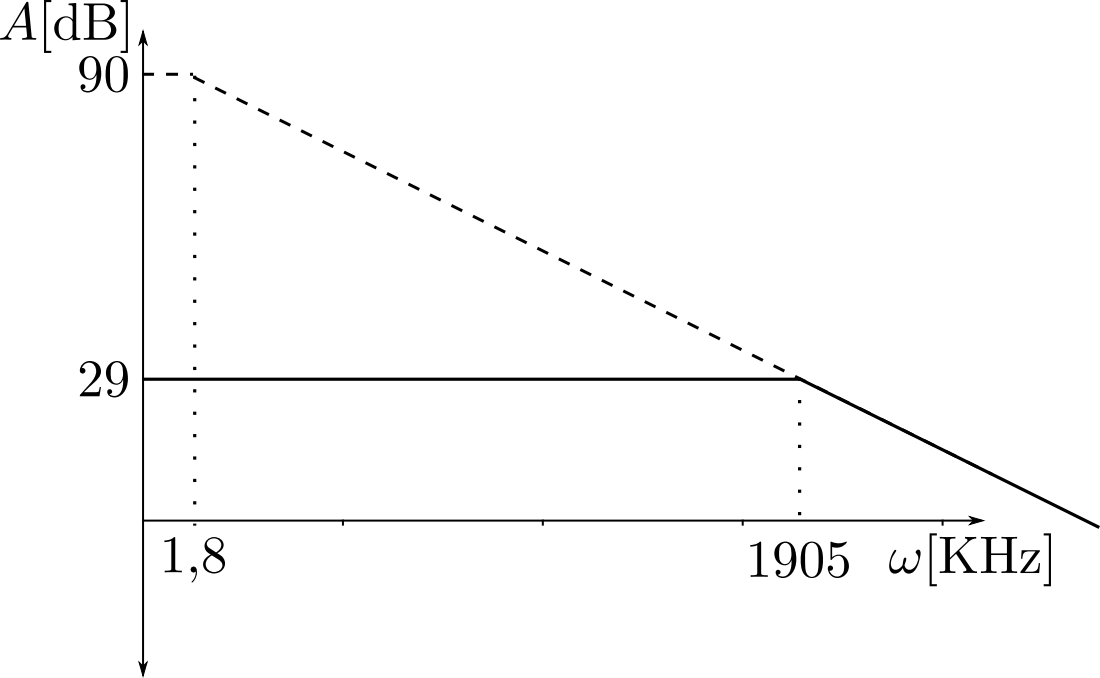
[picture p155: page 1]
