nachocarballeda/gclass_amplifier/informe/img/realimentacion.pdf

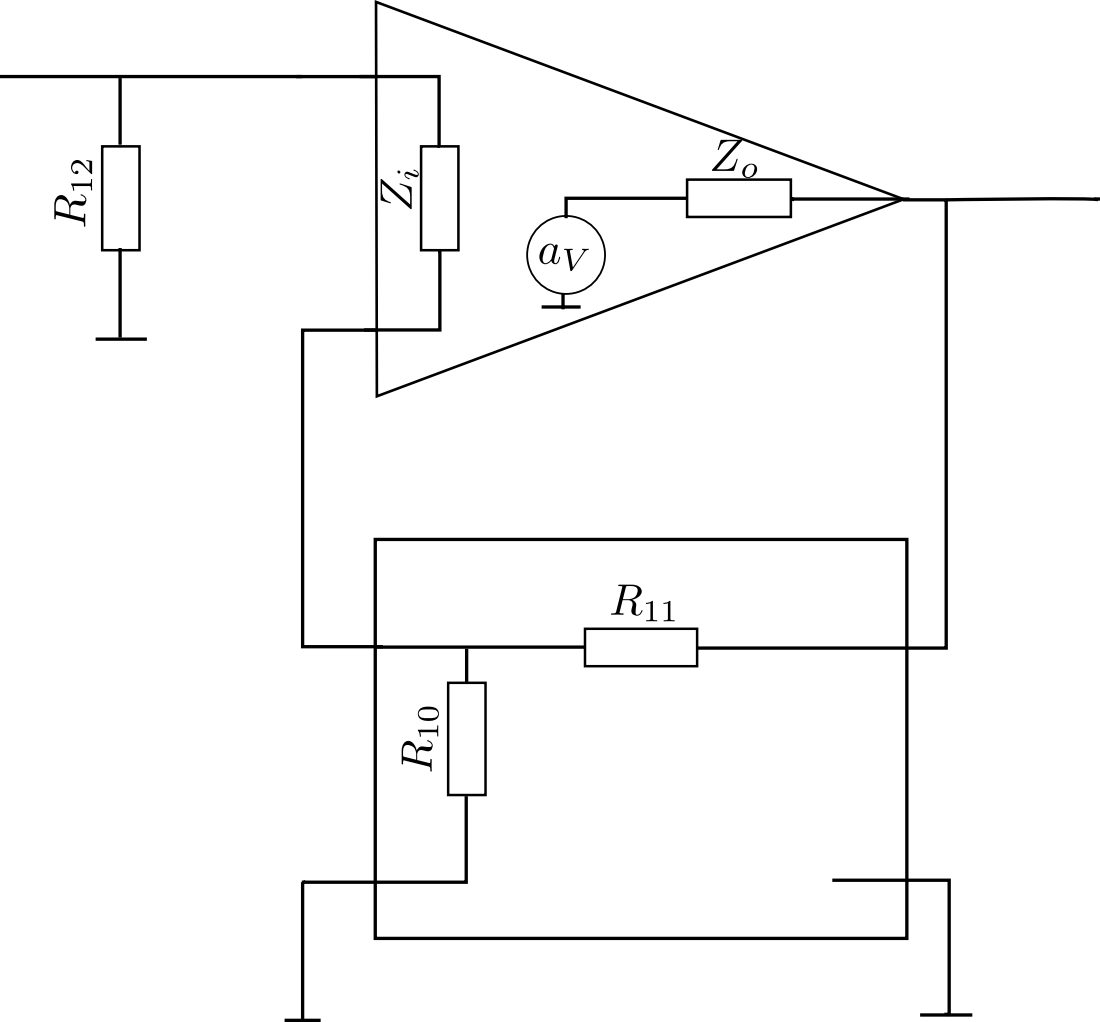
[picture p156: page 1]
