nachocarballeda/gclass_amplifier/informe/img/reflejo.pdf

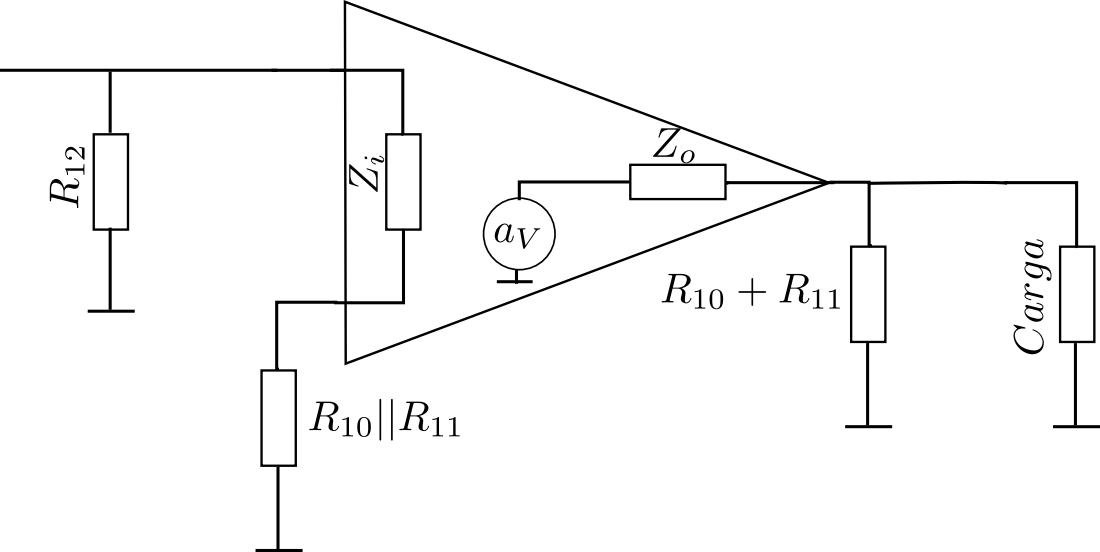
[picture p157: page 1]
