nachocarballeda/gclass_amplifier/informe/img/PCB/amplificador-B.pdf

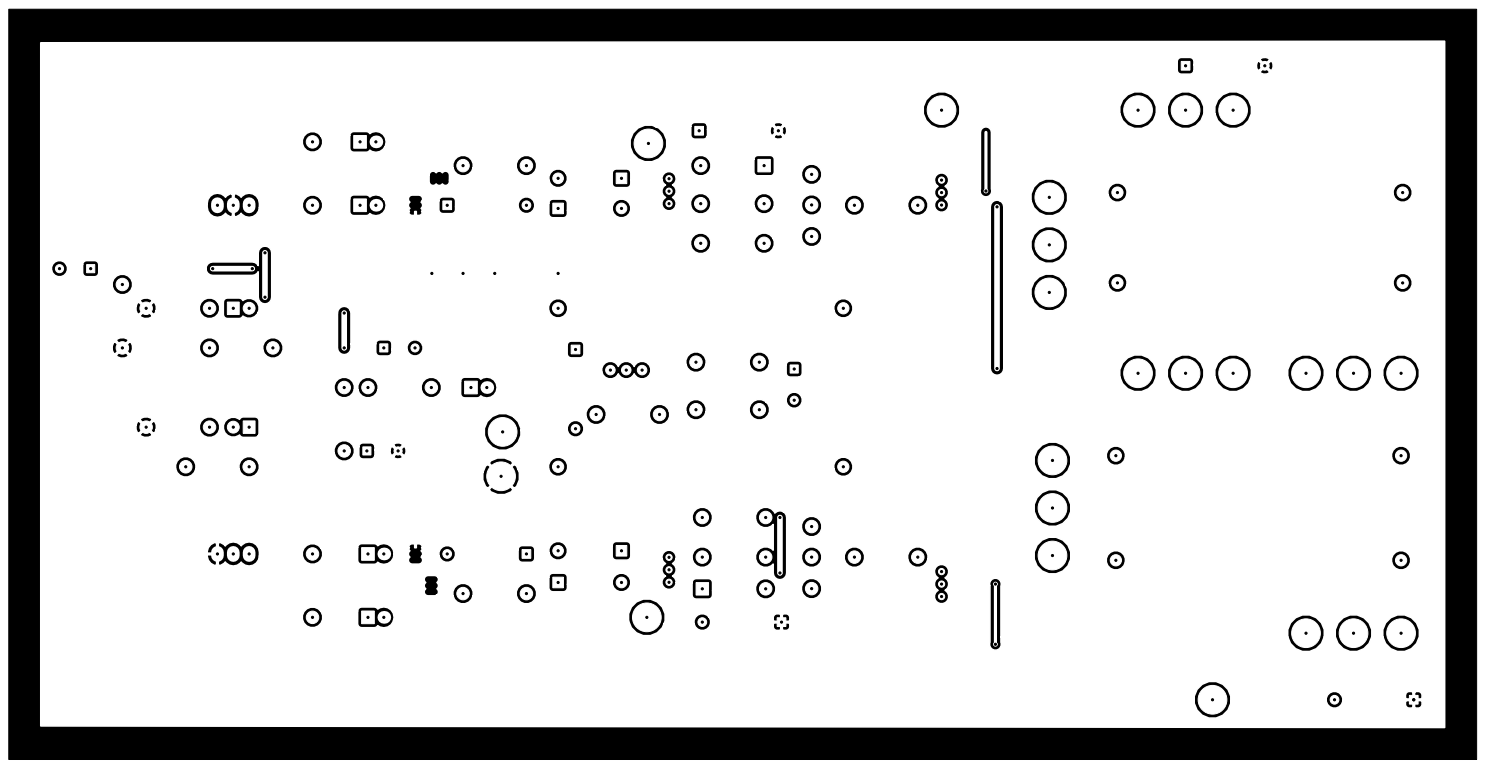
[picture p158: page 1]
