nachocarballeda/gclass_amplifier/informe/img/PCB/amplificador-F.pdf

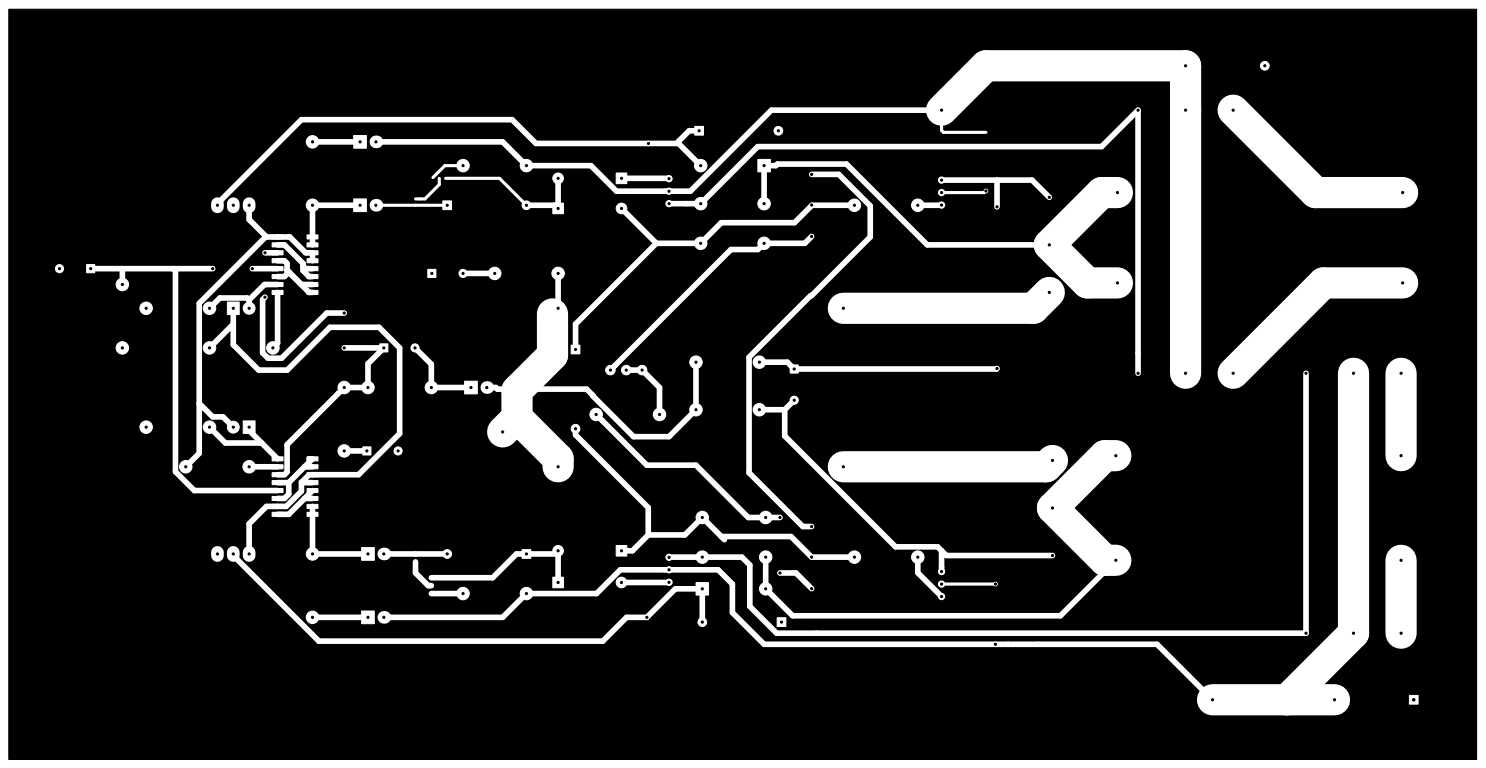
[picture p159: page 1]
