nachocarballeda/gclass_amplifier/informe/img/sim/1era-etapa-bode.pdf

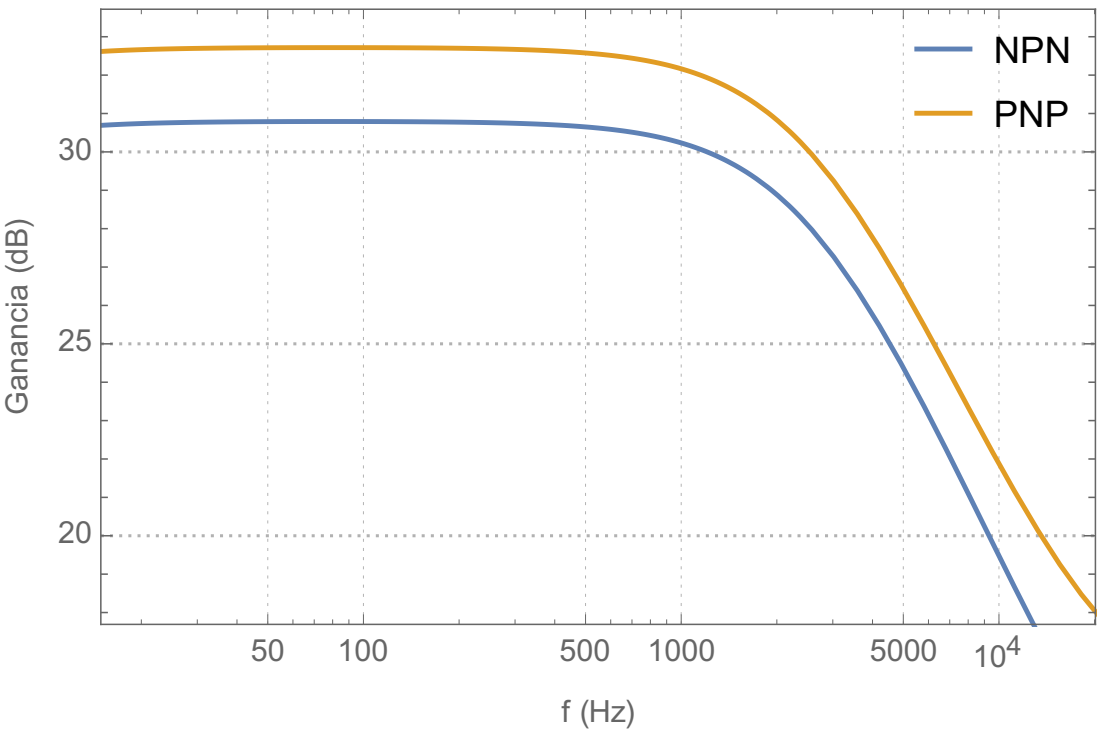
[picture p160: page 1]
NPN; PNP; Ganancia (dB)
