nachocarballeda/gclass_amplifier/informe/img/sim/2da-etapa-bode.pdf

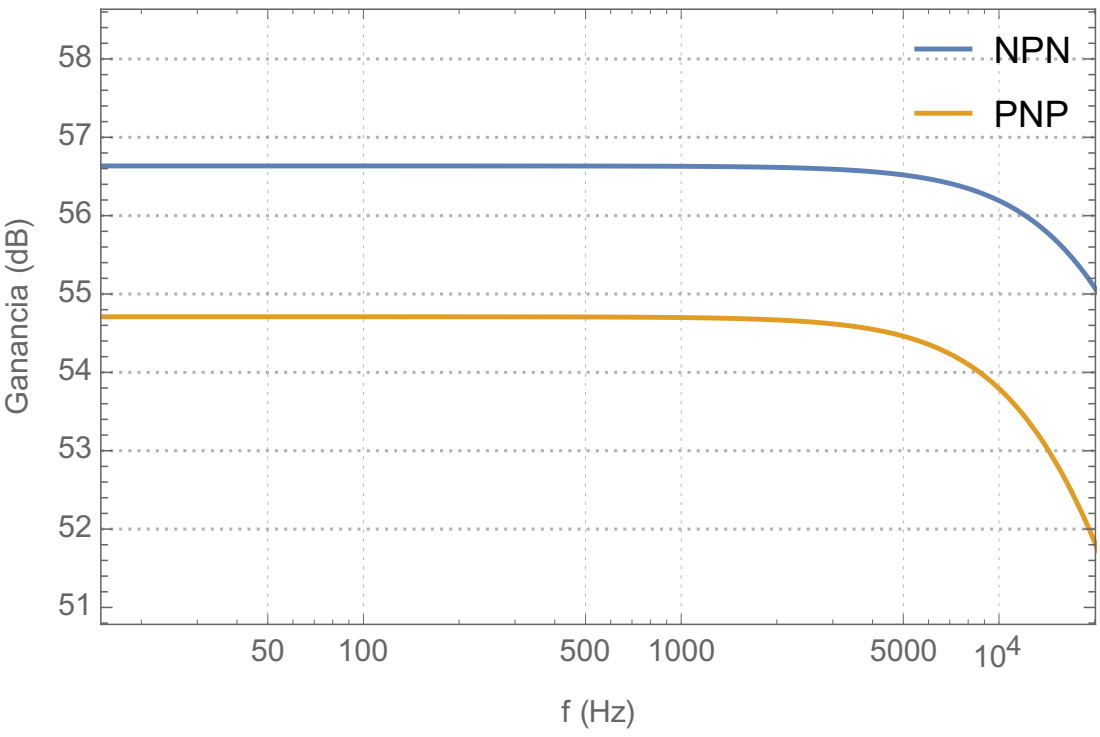
[picture p161: page 1]
Ganancia (dB)

NPN

PNP
