nachocarballeda/gclass_amplifier/informe/img/sim/bode.pdf

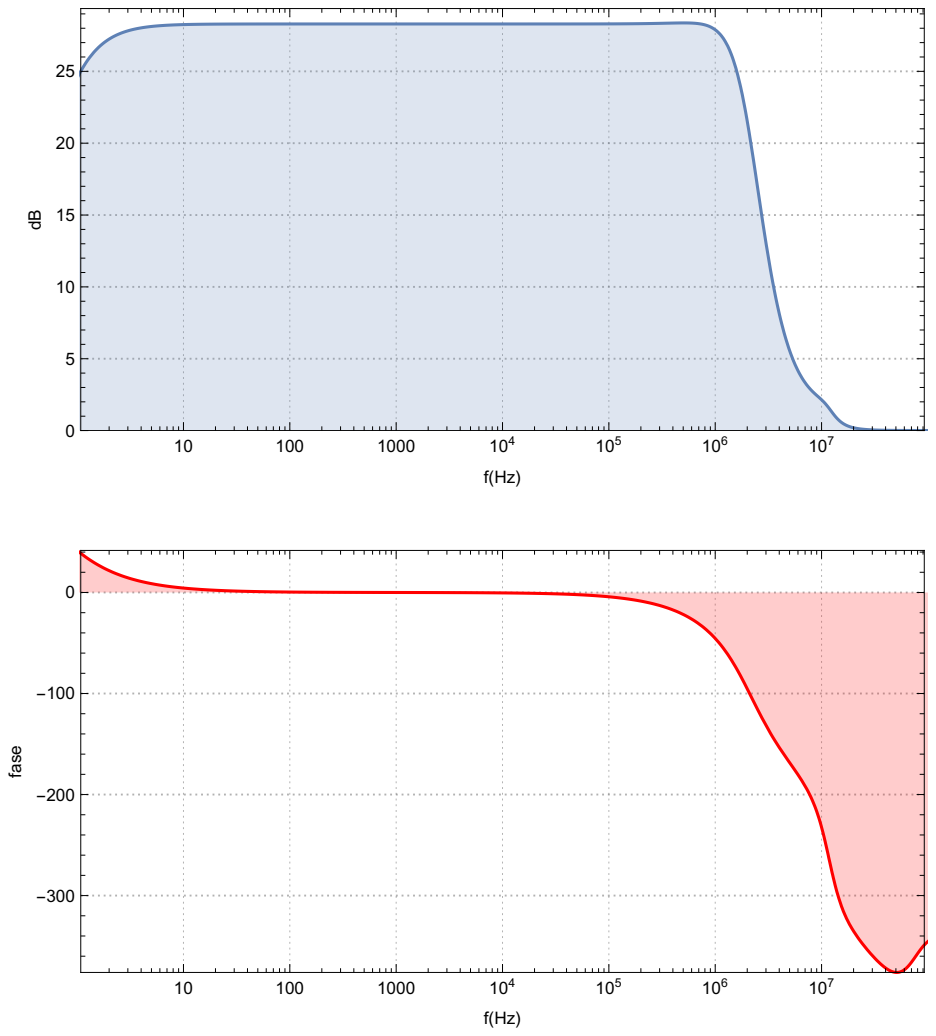
[picture p162: page 1]
fase
