nachocarballeda/gclass_amplifier/informe/img/sim/distorsion-frec.pdf

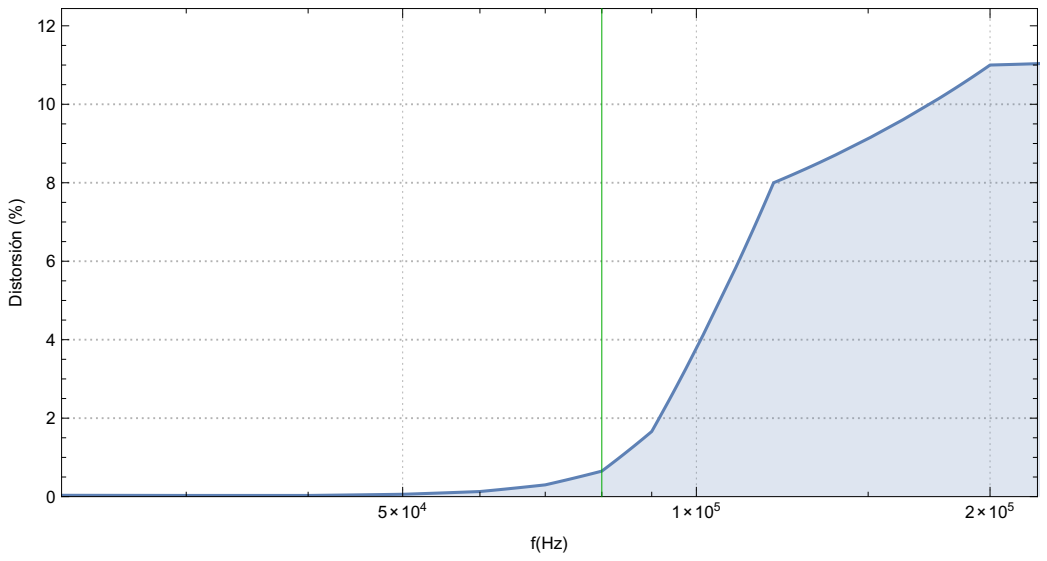
[picture p163: page 1]
Distorsión (%)
