nachocarballeda/gclass_amplifier/informe/img/sim/R_i.pdf

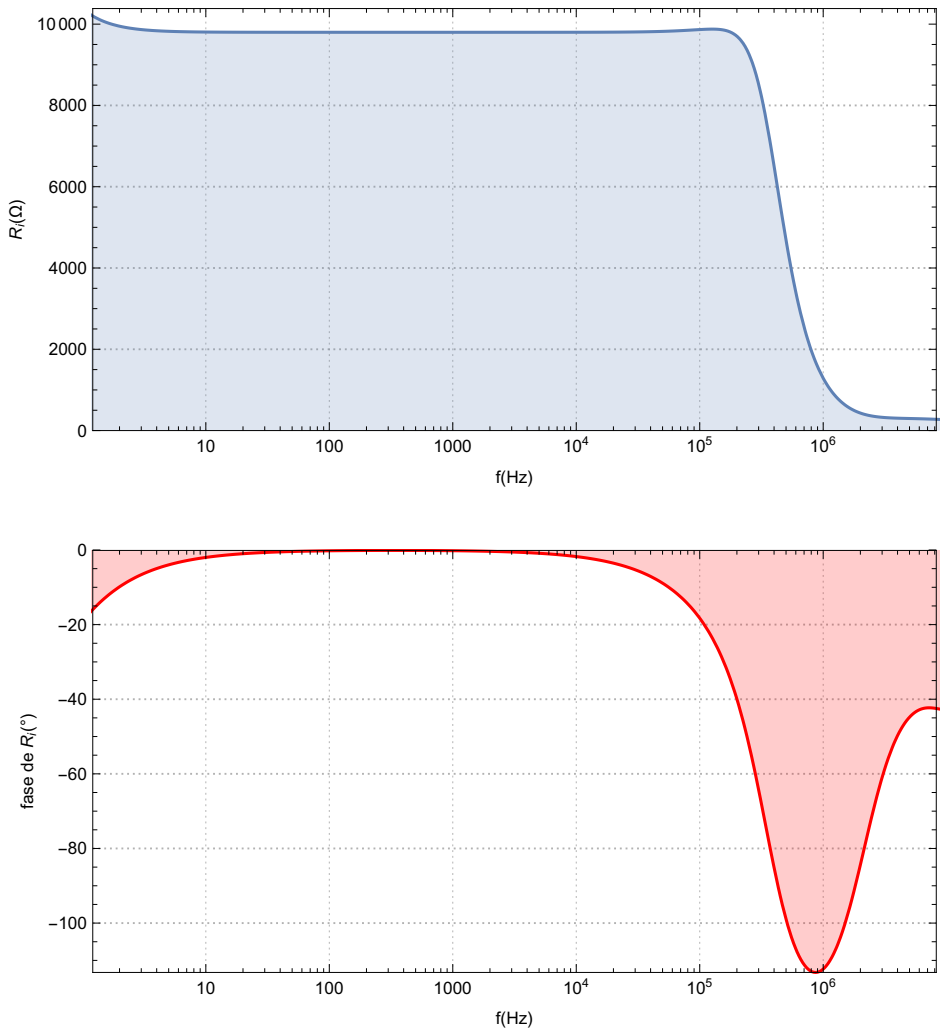
[picture p164: page 1]

fase de Ri(°)
