nachocarballeda/gclass_amplifier/informe/img/sim/R_out-zoom.pdf

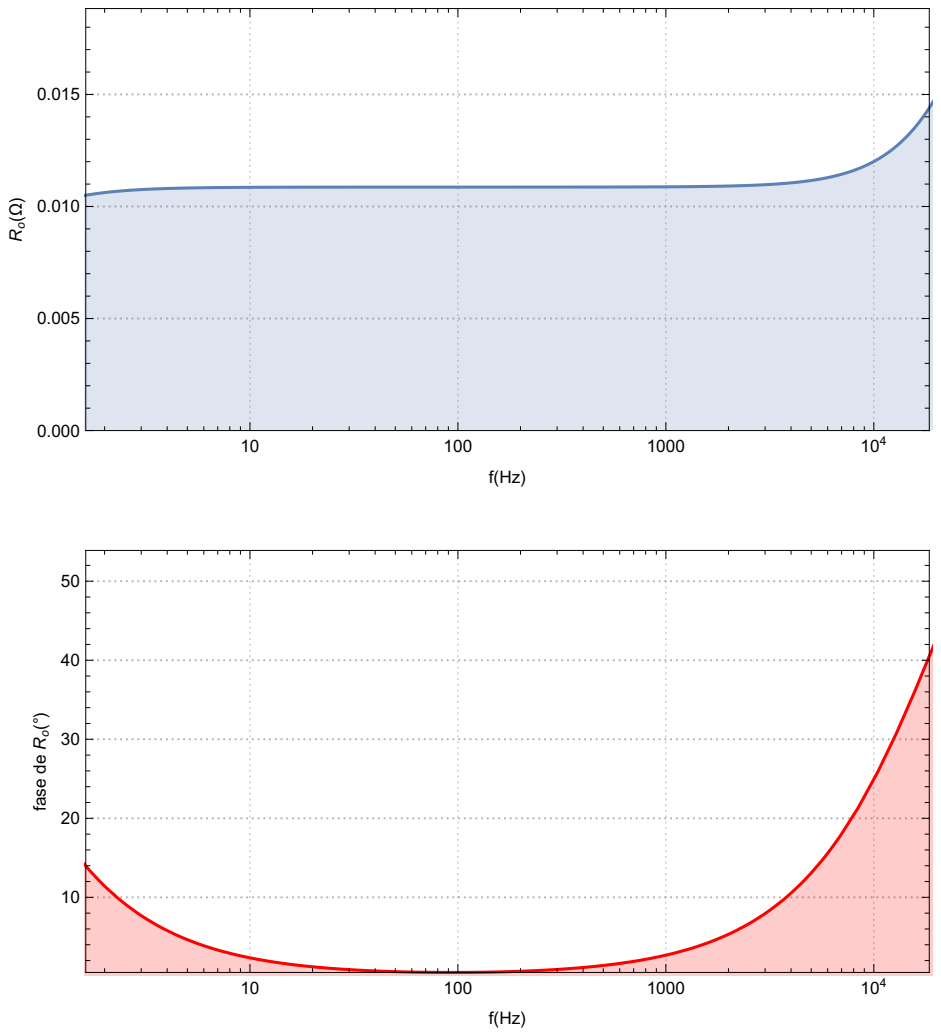
[picture p165: page 1]

fase de Ro(°)
