nachocarballeda/gclass_amplifier/informe/img/sim/R_out.pdf

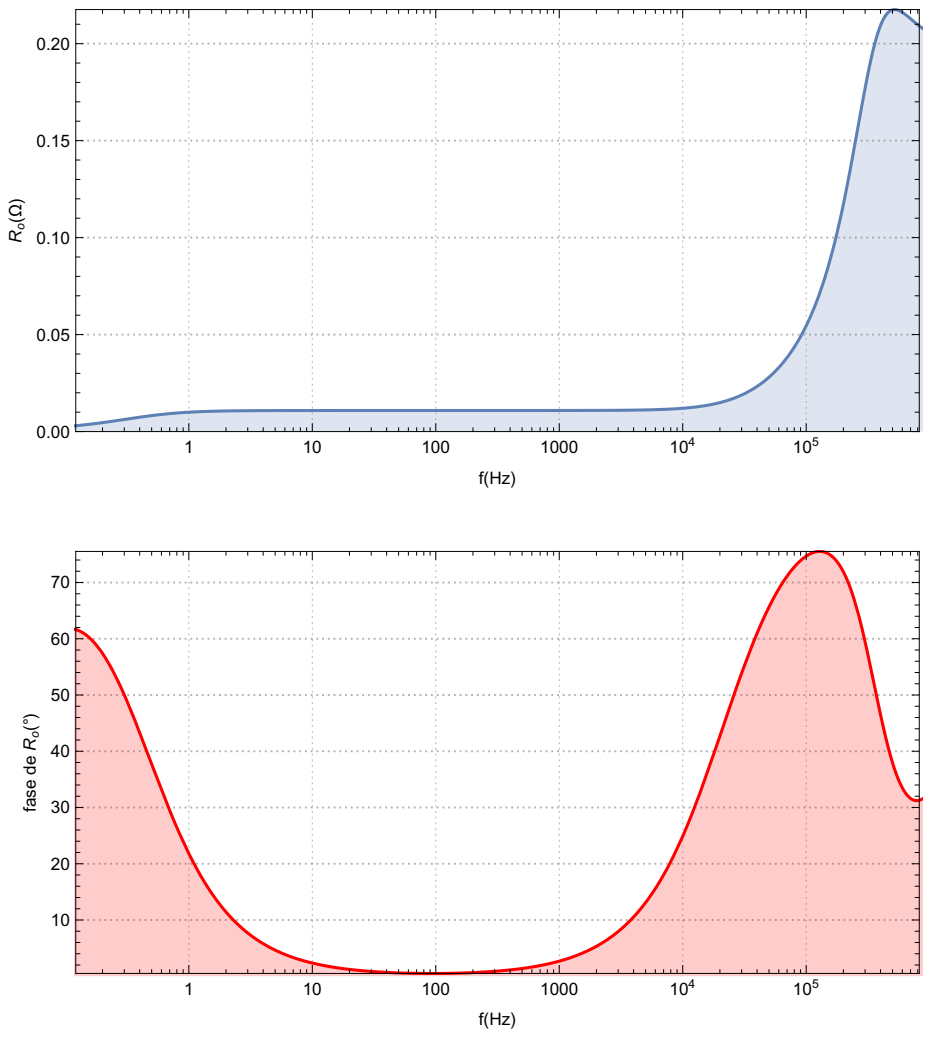
[picture p166: page 1]

fase de Ro(°)
