nachocarballeda/gclass_amplifier/informe/avance/img/fiuba.pdf

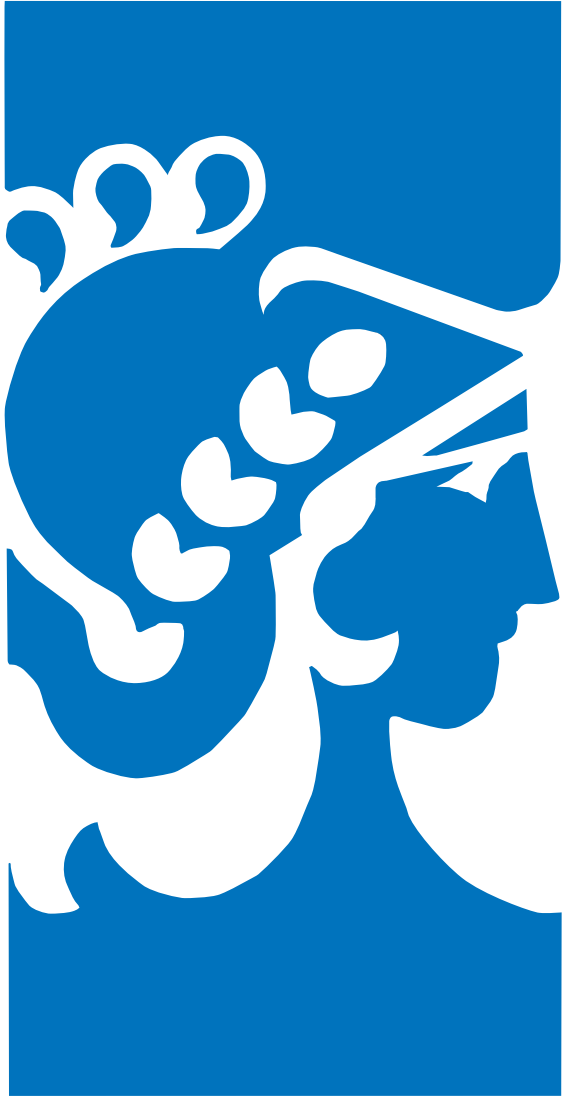
[picture p167: page 1]
