nachocarballeda/gclass_amplifier/pcb/amplificador-B.Cu.pdf

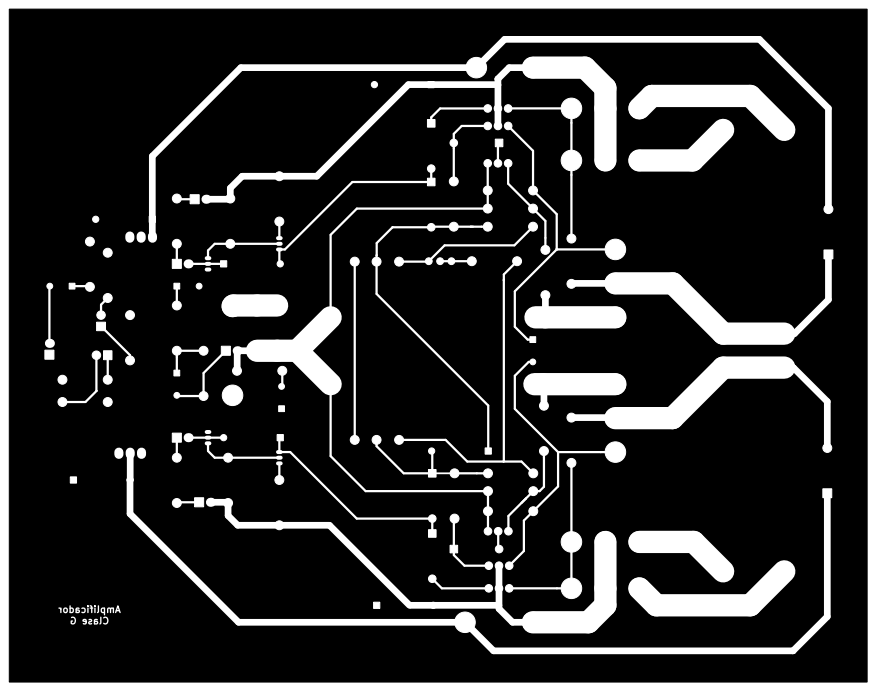
[picture p168: page 1]
