nachocarballeda/gclass_amplifier/pcb/amplificador-F.Cu.pdf

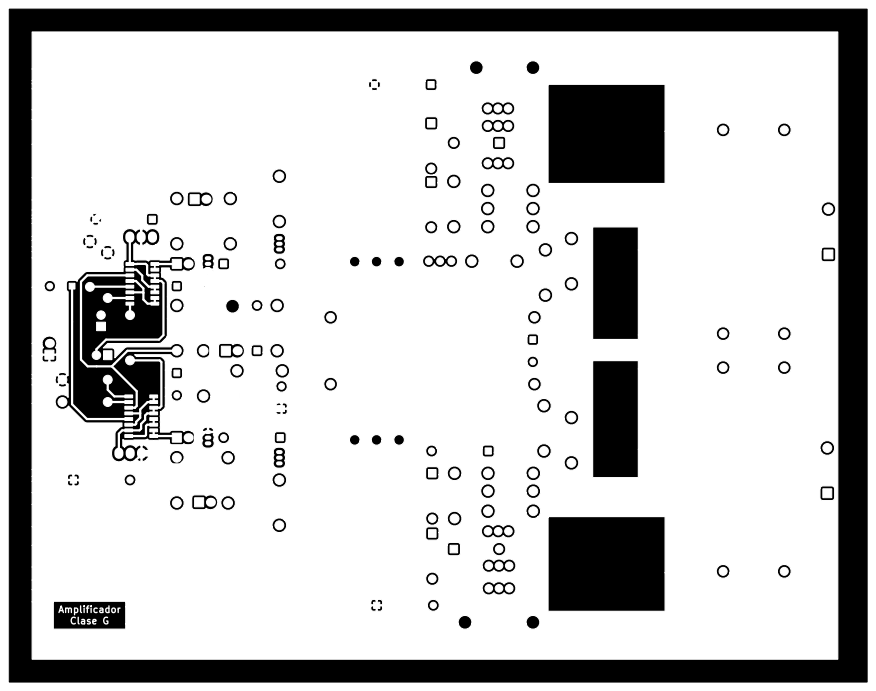
[picture p169: page 1]
