nachocarballeda/gclass_amplifier/pcb/amplificador-F.SilkS.pdf

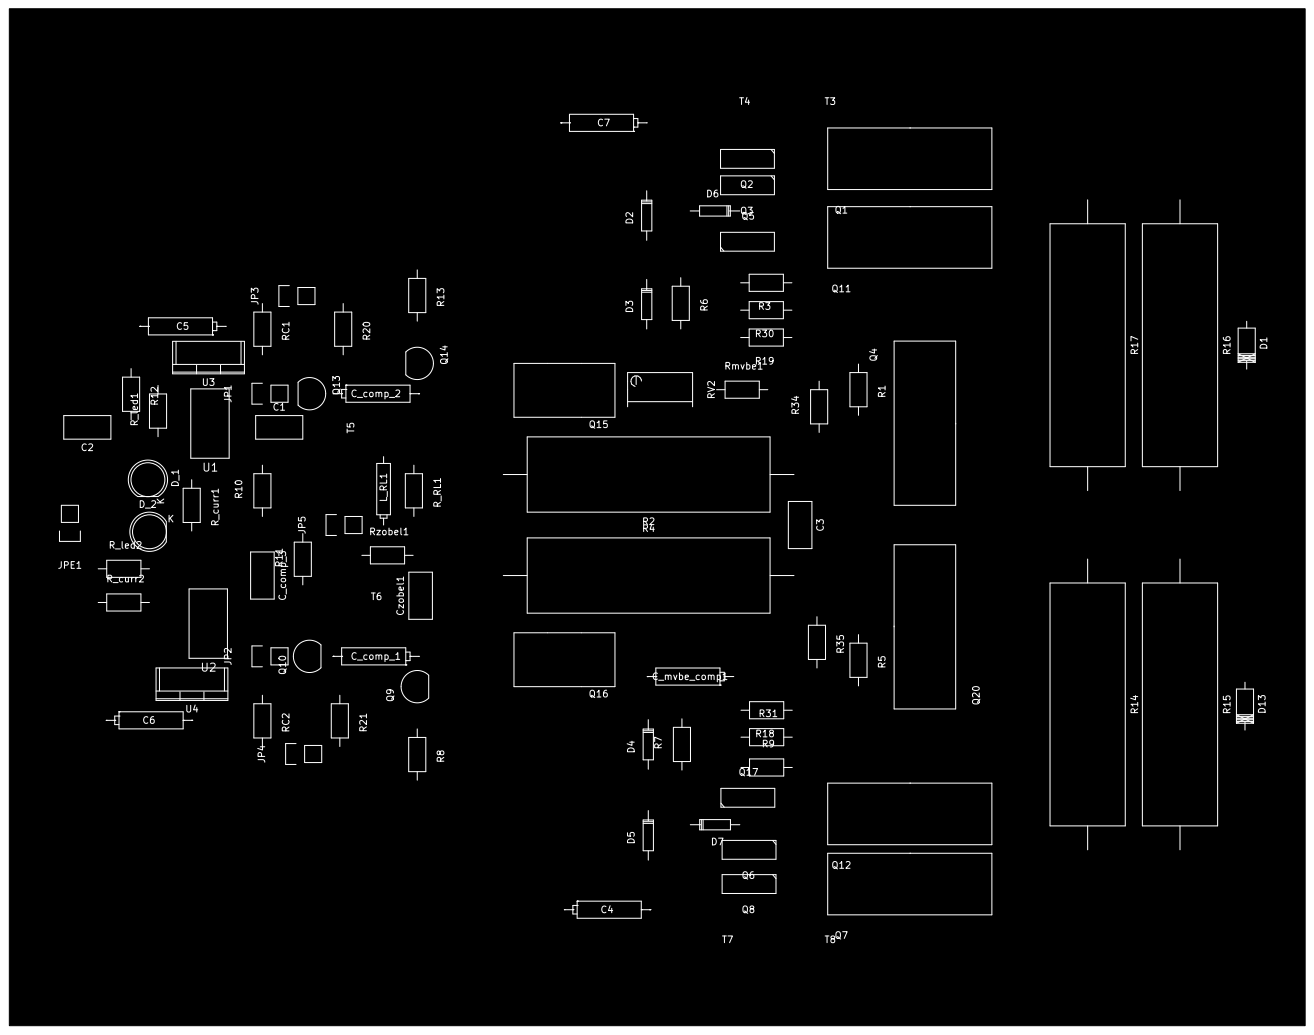
[picture p170: page 1]
