nachocarballeda/gclass_amplifier/sims/res/R-out-zoom.pdf

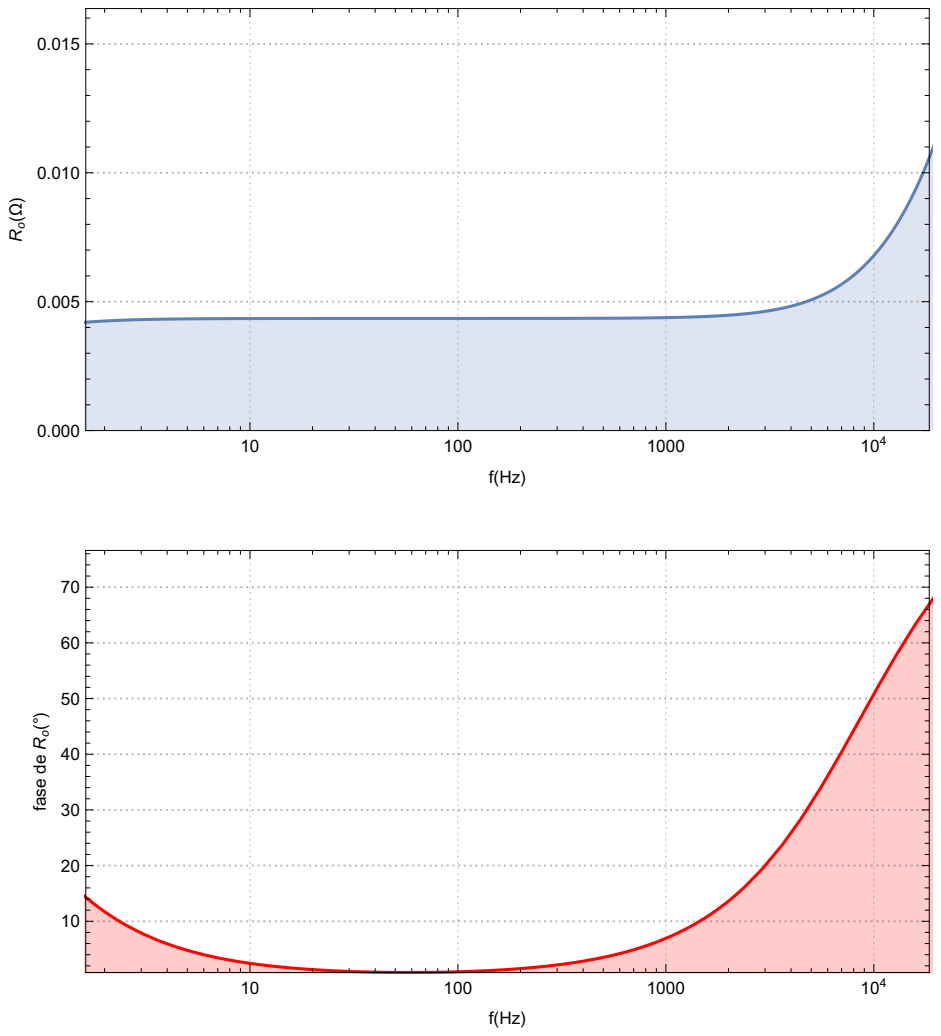
[picture p171: page 1]

fase de Ro(°)
