nachocarballeda/gclass_amplifier/sims/res/R-out.pdf

fase de Ro(°)
