nachocarballeda/gclass_amplifier/sims/test.asc

C1: cap; 1m
C2: cap; 47µ
C3: cap; 10n
C4: cap; 220µ
C5: cap; 220µ
C_comp_1: cap; {c_mull}
C_comp_2: cap; {c_mull}
C_mvbe_comp: cap; 20n
D1: diode; MBR1645
D2: diode; D1N4148
D3: zener; D1N746
D4: zener; D1N746
D5: diode; D1N4148
D6: diode; MBR1645
D_1: LED; LED23
D_2: LED; LED23
Q1: npn; 2SC3281
Q2: npn; MJE340
Q3: npn; MJE340
Q4: npn; 2SC3281
Q5: pnp; 2SA1302
Q6: pnp; MJE350
Q7: pnp; 2SA1302
Q8: pnp; MJE350
Q9: npn; MJE340
Q10: npn; MPSA42
Q11: npn; 2SC3281
Q12: pnp; 2SA1302
Q13: pnp; MPSA92
Q14: pnp; MJE350
Q15: npn; MJE340
Q16: pnp; MJE350
Q17: npn; MMPQ2222A
Q18: npn; MMPQ2222A
Q19: npn; MMPQ2222A
Q20: pnp; MMPQ2907A
Q21: pnp; MMPQ2907A
Q22: pnp; MMPQ2907A
Q_curr1: npn; MMPQ2222A
Q_curr2: pnp; MMPQ2907A
R1: res; 100R
R2: res; 0R22
R3: res; 100R
R4: res; 0R22
R5: res; 100R
R6: res; 100R
R7: res; 100R
R8: res; {rvas}
R9: res; 100R
R10: res; 366R
R11: res; 10k
R12: res; 10k
R13: res; {rvas}
R14: res; 0.1
R15: res; 0.1
R16: res; 0.1
R17: res; 0.1
R18: res; 150
R19: res; 150
R_led1: res; 6.8k
R_led2: res; 6.8k
RC1: res; {RC}
RC2: res; {RC}
RE_curr1: res; {rcurr}
RE_curr2: res; {rcurr}
RECC1: res; 1k
RECC2: res; 1k
RL: res; 8
Rmvbe: res; 357
V1: voltage; SINE(0 2m 1k); AC 1; Rser=50
V2: voltage; {Vcc_real}
V3: voltage; {Vcc_real}
V+VCC: voltage; {VCC_lim}
V+Vcc_low: voltage; {Vcc_low}
V+Vreg: voltage; {Vreg}
V-VCC: voltage; {VCC_lim}
V-Vcc_low: voltage; {Vcc_low}
V-Vreg: voltage; {Vreg}
Named nets: 0, +VCC_lim, +Vcc_low, -Vcc_low, -VCC_lim, -VCC_real, +VCC_real, realim, +Vreg, -Vreg
.tran 0 5m 0
.fourier 1k 20 v(realim)
Fuentes
Simulaciones
;tran 0 12m 1m 20n; distorsion
distorsion
;ac oct 20 0.1 1g
.lib models.mod
Multiplicador de VBE
Reguladores
prov
Realimentador global
NT2
NT3
NT1
NT4
PT2
NT<N> , donde N es el Numero de transistor de MMPQ2222A
PT<N> , donde N es el Numero de transistor de MMPQ2907A
NOTA: Relacionando transistores con integrados del esquematico.
PT1
PT3
Entrada
.param Vcc_low=24.3
.param Vreg=9
.param RC=2.4k
.param rvas=100
.param rcurr=420
;tran 0 20m 5m 100n
;.param rcurr=840
.param c_mull=60p
.param VCC_lim=23.3
.param VCC_real=24
