nachocarballeda/gclass_amplifier/sims/lasthope-prueba3.asc

C1: cap; 20n
C2: cap; 47µ
C3: cap; 10n
C4: cap; 1m
C_comp_1: cap; {c_mull}
C_comp_2: cap; {c_mull}
D1: diode; MBR1645
D3: zener; D1N746
D4: zener; D1N746
D6: diode; MBR1645
D_1: LED; LED18
D_2: LED; LED18
Q3: npn; MJE340
Q4: npn; 2SC3281
Q5: pnp; 2SA1302
Q6: pnp; MJE350
Q9: npn; MJE340
Q10: npn; MPSA42
Q13: pnp; MPSA92
Q14: pnp; MJE350
Q15: npn; MJE340
Q16: pnp; MJE350
Q17: npn; MMPQ2222A
Q18: npn; MMPQ2222A
Q19: npn; MMPQ2222A
Q20: pnp; MMPQ2907A
Q21: pnp; MMPQ2907A
Q22: pnp; MMPQ2907A
Q_curr1: npn; MMPQ2222A
Q_curr2: pnp; MMPQ2907A
R1: res; 10k
R2: res; 0R22
R3: res; 100R
R4: res; 0R22
R5: res; 366
R6: res; 100R
R7: res; 100R
R8: res; {rvas}
R9: res; 100R
R10: res; 10k
R11: res; 10k
R12: res; 10k
R13: res; {rvas}
R14: res; 1k
R15: res; 47
R16: res; 47
R17: res; 47
R18: res; 150
R19: res; 150
R20: res; 47
R21: res; 3
R22: res; 47
R23: res; 47
R24: res; 47
R25: res; 47
R26: res; 47
R27: res; 47
R28: res; 47
R29: res; 47
R30: res; 47
R31: res; 47
R32: res; 3
R_led1: res; 6.8k
R_led2: res; 6.8k
RC1: res; {RC}
RC2: res; {RC}
RE_curr1: res; {rcurr}
RE_curr2: res; {rcurr}
RECC1: res; 1k
RECC2: res; 1k
Rmvbe: res; {rmul}
V1: voltage; SINE(0 100m 1k)
V2: voltage; {Vcc_real}
V3: voltage; {Vcc_real}
V+VCC: voltage; {VCC_lim}
V+Vcc_low: voltage; {Vcc_low}
V+Vreg: voltage; {Vreg}
V-VCC: voltage; {VCC_lim}
V-Vcc_low: voltage; {Vcc_low}
V-Vreg: voltage; {Vreg}
Named nets: 0, +VCC_lim, +Vcc_low, -Vcc_low, -VCC_lim, realim, +Vreg, -Vreg, +VCC_real, -VCC_real
.tran 0 20m 0
.fourier 1k 20 v(realim)
Fuentes
Simulaciones
;tran 0 12m 1m 20n; distorsion
distorsion
;ac oct 20 0.1 1g
.lib models.mod
Multiplicador de VBE
Reguladores
prov
Realimentador global
NT2
NT3
NT1
NT4
PT2
NT<N> , donde N es el Numero de transistor de MMPQ2222A
PT<N> , donde N es el Numero de transistor de MMPQ2907A
NOTA: Relacionando transistores con integrados del esquematico.
PT1
PT3
PT4
.param Vcc_low=23.5
.param Vreg=12
.param RC=2.4k
.param rvas=33
.param rcurr=560
;tran 0 62m 50m 100n
;.param rcurr=840
.param c_mull=40p
.param VCC_lim=68
.param VCC_real=70
.param rmul=350
Con señal. Realimentado. Sin carga. Baja tensión
Empezar a cargar, de más resistencia a menos. O sea, de más potencia a menos
pot >625mW
pot >3.2W
pot >3.2W
Potencias calculadas con entrada al mango para fuente baja tensión
pot >63mW
pot >12.5
pot >12.5W
PARLANTE. 750mW
67W total, 13.5W c/u
39W total, 8W c/u
PARLANTE. 13W
50.5W total
