nachocarballeda/gclass_amplifier/sims/pruebas/zobel.asc

C1: cap; 2µ
Czob1: cap; 100n
L1: ind; 5µ
R1: res; 0.5
RL1: res; 8
Rzob1: res; 10
V1: voltage; PULSE(-15 15 1m 1u 1f 0.8 1 1)
Named nets: 0
Carga
Zobel
.tran 0 1.5m 0.96m
Red R-L
