nachocarballeda/gclass_amplifier/sims/pruebas/pruebas-fc/ampli-div-ten.asc

RL: res; 8
V1: voltage; SINE(0 1.41 1k); AC 1
V+15: voltage; 15
V+50: voltage; 50
V-15: voltage; 15
V-50: voltage; 50
X1: ss-ampli-div-ten
Named nets: 0, +50, +15, -15, -50
;tran 0 12m 1m
.fourier 1k 20 v(n002)
Fuentes
Simulaciones
.tran 0 12m 1m 20n; distorsion
distorsion
0.014%
;ac oct 20 1 1g
.param offset=0
