nachocarballeda/gclass_amplifier/sims/pruebas/protecciones/probandoprotecciones10-jun.asc

C1: cap; 1m
C2: cap; 47µ
C3: cap; 10n
C4: cap; 220µ
C5: cap; 220µ
C6: cap; 220µ
C7: cap; 220µ
C_comp_1: cap; 40p
C_comp_2: cap; 40p
C_comp_3: cap; 4p
C_mvbe_comp: cap; 20n
Czob: cap; 100n
D1: diode; MBR1645
D2: diode; D1N4148
D3: zener; D1N746
D4: zener; D1N746
D5: diode; D1N4148
D6: diode; MBR1645
D7: diode; D1N4148
D8: diode; D1N4148
D_1: LED; AOT-2015
D_2: LED; AOT-2015
L1: ind; 5µ
Q1: npn; 2SC3281
Q2: npn; MJE340
Q3: npn; MJE340
Q4: npn; 2SC3281
Q5: pnp; 2SA1302
Q6: pnp; MJE350
Q7: pnp; 2SA1302
Q8: pnp; MJE350
Q9: npn; MPSA42
Q10: npn; MPSA42
Q11: npn; 2SC3281
Q12: pnp; 2SA1302
Q13: pnp; MPSA92
Q14: pnp; MPSA92
Q15: npn; MJE340
Q16: pnp; MJE350
Q17: npn; MMPQ2222A
Q18: npn; MMPQ2222A
Q19: npn; MMPQ2222A
Q20: pnp; MMPQ2907A
Q21: pnp; MMPQ2907A
Q22: pnp; MMPQ2907A
Q23: pnp; MPSA92
Q24: npn; MPSA42
Q25: npn; MPSA42
Q26: pnp; MPSA92
Q_curr1: npn; MMPQ2222A
Q_curr2: pnp; MMPQ2907A
R1: res; 100R
R2: res; 0R25
R3: res; 100R
R4: res; 0R25
R5: res; 100R
R6: res; 100R
R7: res; 100R
R8: res; 33
R9: res; 100R
R10: res; 366R
R11: res; 10k
R12: res; 10k
R13: res; 33
R14: res; 0.1
R15: res; 0.1
R16: res; 0.1
R17: res; 0.1
R18: res; 150
R19: res; 150
R20: res; 10
R21: res; 60
R22: res; 10
R23: res; 60
R24: res; 10
R25: res; 700R
R26: res; 330R
R27: res; 100
R28: res; 2R
R29: res; 50R
R30: res; 33R
R32: res; 100
R_led1: res; 6.8k
R_led2: res; 6.8k
RC1: res; 2.4k
RC2: res; 2.4k
RE_curr1: res; 820
RE_curr2: res; 820
RECC1: res; 1k
RECC2: res; 1k
Rmvbe: res; 270
Rzob: res; 10
V1: voltage; SINE(0 1.43 1k); AC 1; Rser=50
V2: voltage; 8
V3: voltage; 8
V+15: voltage; 15
V+50: voltage; 50
V-15: voltage; 15
V-50: voltage; 50
Named nets: 0, +50, +15, -15, -50, realim, grnd, +9, -9
;tran 0 12m 1m
.fourier 1k 20 v(realim)
Fuentes
Simulaciones
.tran 0 3m 1m 20n; distorsion
distorsion
;ac oct 20 0.1 1g
.lib models.mod
Multiplicador de VBE
Reguladores
prov
Realimentador global
NT2
NT3
NT1
NT4
PT2
NT<N> , donde N es el Numero de transistor de MMPQ2222A
PT<N> , donde N es el Numero de transistor de MMPQ2907A
NOTA: Relacionando transistores con integrados del esquematico.
PT1
PT3
PT4
Zobel
Entrada
Carga
