nachocarballeda/gclass_amplifier/sims/pruebas/pruebas-fc/ampli-div-ten-la.asc

C1: cap; 1
C2: cap; 1m
C3: cap; 25p
R1: res; 366
R2: res; 10k
RL: res; 8
V1: voltage; SINE(0 100u 1k); AC 1
V+15: voltage; 15
V+50: voltage; 50
V-15: voltage; 15
V-50: voltage; 50
X1: ss-ampli-div-ten
Named nets: 0, +50, +15, -15, -50
;tran 0 12m 1m
.fourier 1k 20 v(n002)
Fuentes
Simulaciones
;tran 0 12m 1m 20n; distorsion
distorsion
0.014%
.ac oct 20 1 1g
.step param offset list 0 -0.2 -0.4 -0.6 -0.8 -1 -1.2 -1.4
