nachocarballeda/gclass_amplifier/sims/pruebas/pruebas-fc/slew-div-ten.asc

RL: res; 8
V1: voltage; PULSE(0 1 0.1m 1f 1f 1m 2m); AC 1
V+15: voltage; 15
V+50: voltage; 50
V-15: voltage; 15
V-50: voltage; 50
X1: ss-ampli-div-ten
Named nets: 0, +50, +15, -15, -50
;tran 0 11m 1m 20n uic
.tran 0 220u 98u 10n uic
;step param vaf list 10 50 100
;tran 0 100m 1m 10u uic
