nachocarballeda/gclass_amplifier/sims/pruebas/pruebas-fc/ss-ampli-div-ten.asc

C1: cap; 47u
C2: cap; 47u
C3: cap; 47u
C4: cap; 30n
C5: cap; 65p
C6: cap; 50n
C8: cap; 1m
C13: cap; 220u
C14: cap; 220u
C15: cap; 10n
C16: cap; 220u
C17: cap; 220u
D8: zener; D1N746
D9: zener; D1N746
D10: diode; D1N4148
D11: diode; D1N4148
D12: diode; MBR1645
D13: diode; MBR1645
mvbe: ss-mult-vbe
Q10: npn; MPSA42
Q11: npn; MPSA42
Q13: pnp; MPSA92
Q14: npn; MJE340
Q15: pnp; MJE350
Q16: npn; MJE340
Q17: pnp; MJE350
Q18: pnp; MPSA92
Q19: npn; 2SC3281
Q20: pnp; 2SA1302
Q1801: npn; 2SC3281
Q1802: npn; 2SC3281
Q2101: pnp; 2SA1302
Q2102: pnp; 2SA1302
R1: res; 47k
R2: res; 5.6k
R3: res; 10k
R4: res; 0.1
R5: res; 0.1
R6: res; 0.1
R7: res; 0.1
R8: res; 5.6k
R9: res; 47k
R14: res; 33
R15: res; 366R
R16: res; 10k
R20: res; 100R
R26: res; 33
R28: res; 100R
R29: res; 100R
R32: res; 100R
R33: res; 100R
R36: res; 100R
R37: res; 0R25
R40: res; 0R25
V1: voltage; {offset*28.2843}
V2: voltage; {offset}
X1: ss-doble-par-comp-div-ten
Named nets: -50, -15, +50, +15, realim, Realim, i, grnd, o, i_aux, 0
.lib models.mod
