nachocarballeda/gclass_amplifier/sims/pruebas/pruebas-fc/ss-doble-par-comp-div-ten.asc

R1: res; 10
R2: res; 60
R3: res; 10
R4: res; 60
V1: voltage; 8
V2: voltage; 8
X3: ss-par-npn-comp-div-ten
X4: ss-par-pnp-comp-div-ten
Named nets: +9, -50, -9, o1, o2, +50, i-, i+, grnd, +15, -15
Reguladores
prov
