nachocarballeda/gclass_amplifier/sims/pruebas/pruebas-fc/ss-mult-vbe.asc

C_comp: cap; 1u
Q1: npn; MJE340
Q2: pnp; MJE350
R+: res; 150
R-: res; 150
R_fija_corriente: res; 270
Named nets: +mvbe, -mvbe
La corriente externa debe ser mayor a la de las resistencias o entra en corte
NOTAS
.lib models.mod
