nachocarballeda/gclass_amplifier/sims/pruebas/pruebas-fc/ss-par-npn-comp-div-ten.asc

D_2.3V: LED; AOT-2015
Q1: npn; MPSA42
Q2: npn; MPSA42
Q4: npn; MPSA42
Q_curr: npn; MPSA42
R_led: res; 6.8k
RC: res; {rc}
RE_curr: res; 820
Named nets: +9, o, i+, i-, -9, +50, grnd
.lib models.mod
Si RC era muy grande
