nachocarballeda/gclass_amplifier/sims/pruebas/pruebas-fc/ss-par-pnp-comp-div-ten.asc

D_2.3V: LED; AOT-2015
Q1: pnp; MPSA92
Q2: pnp; MPSA92
Q3: pnp; MPSA92
Q_curr: pnp; MPSA92
R_led: res; 6.8k
RC: res; {rc}
RE_curr: res; 820
Named nets: +9, -9, -50, i-, i+, o, grnd
.lib models.mod
