nachocarballeda/gclass_amplifier/sims/pruebas/pruebas-rui/ss-doble-par-cascode.asc

X1: ss-par-cascode-npn; rc={rcs}
X2: ss-par-cascode-pnp; rc={rcs}
Named nets: +9, -50, -9, o1, o2, +50, i-, i+, grnd
