nachocarballeda/gclass_amplifier/sims/pruebas/pruebas-rui/ss-par-cascode-npn.asc

D2: LED; NSCW100
Q1: npn; MPSA42
Q2: npn; MPSA42
Q3: npn; MPSA42
Q4: npn; MPSA42
R4: res; 270
R5: res; 1.5k
R6: res; {rc}
Named nets: +9, o, i+, i-, -9, +50, grnd
OJO que no sé si se consigue,
 puse cualquira
.MODEL MPSA42 NPN(
+ IS=18.36E-15
+ BF=60.596
+ VAF=9.2909
+ IKF=.0207
+ ISE=1.3215E-12
+ NE=1.7767
+ NF=1.15
+ BR=499.50
+ VAR=100
+ IKR=19.980
+ ISC=75E-9
+ NC=3.9970
+ RE=490.00E-6
+ RB=5.2315
+ RC=1.0000E-3
+ CJE=104.69E-12
+ VJE=1.0643
+ MJE=.41036
+ CJC=9.8356E-12
+ VJC=.35
+ MJC=.28065
+ TF=5.1798E-9
+ XTF=3.2122
+ VTF=25.040
+ ITF=.19258
+ XTB=1.5
+ TR=6.837E-6)
