nachocarballeda/gclass_amplifier/sims/pruebas/pruebas-rui/ampli_cascode-dobleEC.asc

RL: res; 8
V1: voltage; SINE(0 1m 1k); AC 1
V+15: voltage; 15
V+50: voltage; 50
V-15: voltage; 15
V-50: voltage; 50
X1: ss-ampli-g-cascode-dobleEC
Named nets: 0, +50, +15, -15, -50
.tran 0 12m 1m
.fourier 1k 20 v(n002)
;ac oct 20 0.1 100meg
