nachocarballeda/gclass_amplifier/(list of files, drawings)

Other design files:
sims/SpiceModels/THS4532_PSPICE_AIO/THS4532.DSN
sims/SpiceModels/THS4532_PSPICE_AIO/THS4532.OLB
sims/SpiceModels/THS4532_PSPICE_AIO/THS4532.opj
