nachocarballeda/gclass_amplifier/pcb/amplificador.kicad_pcb

## KiCad design pcb/amplificador.kicad_pcb (2017-08-04)

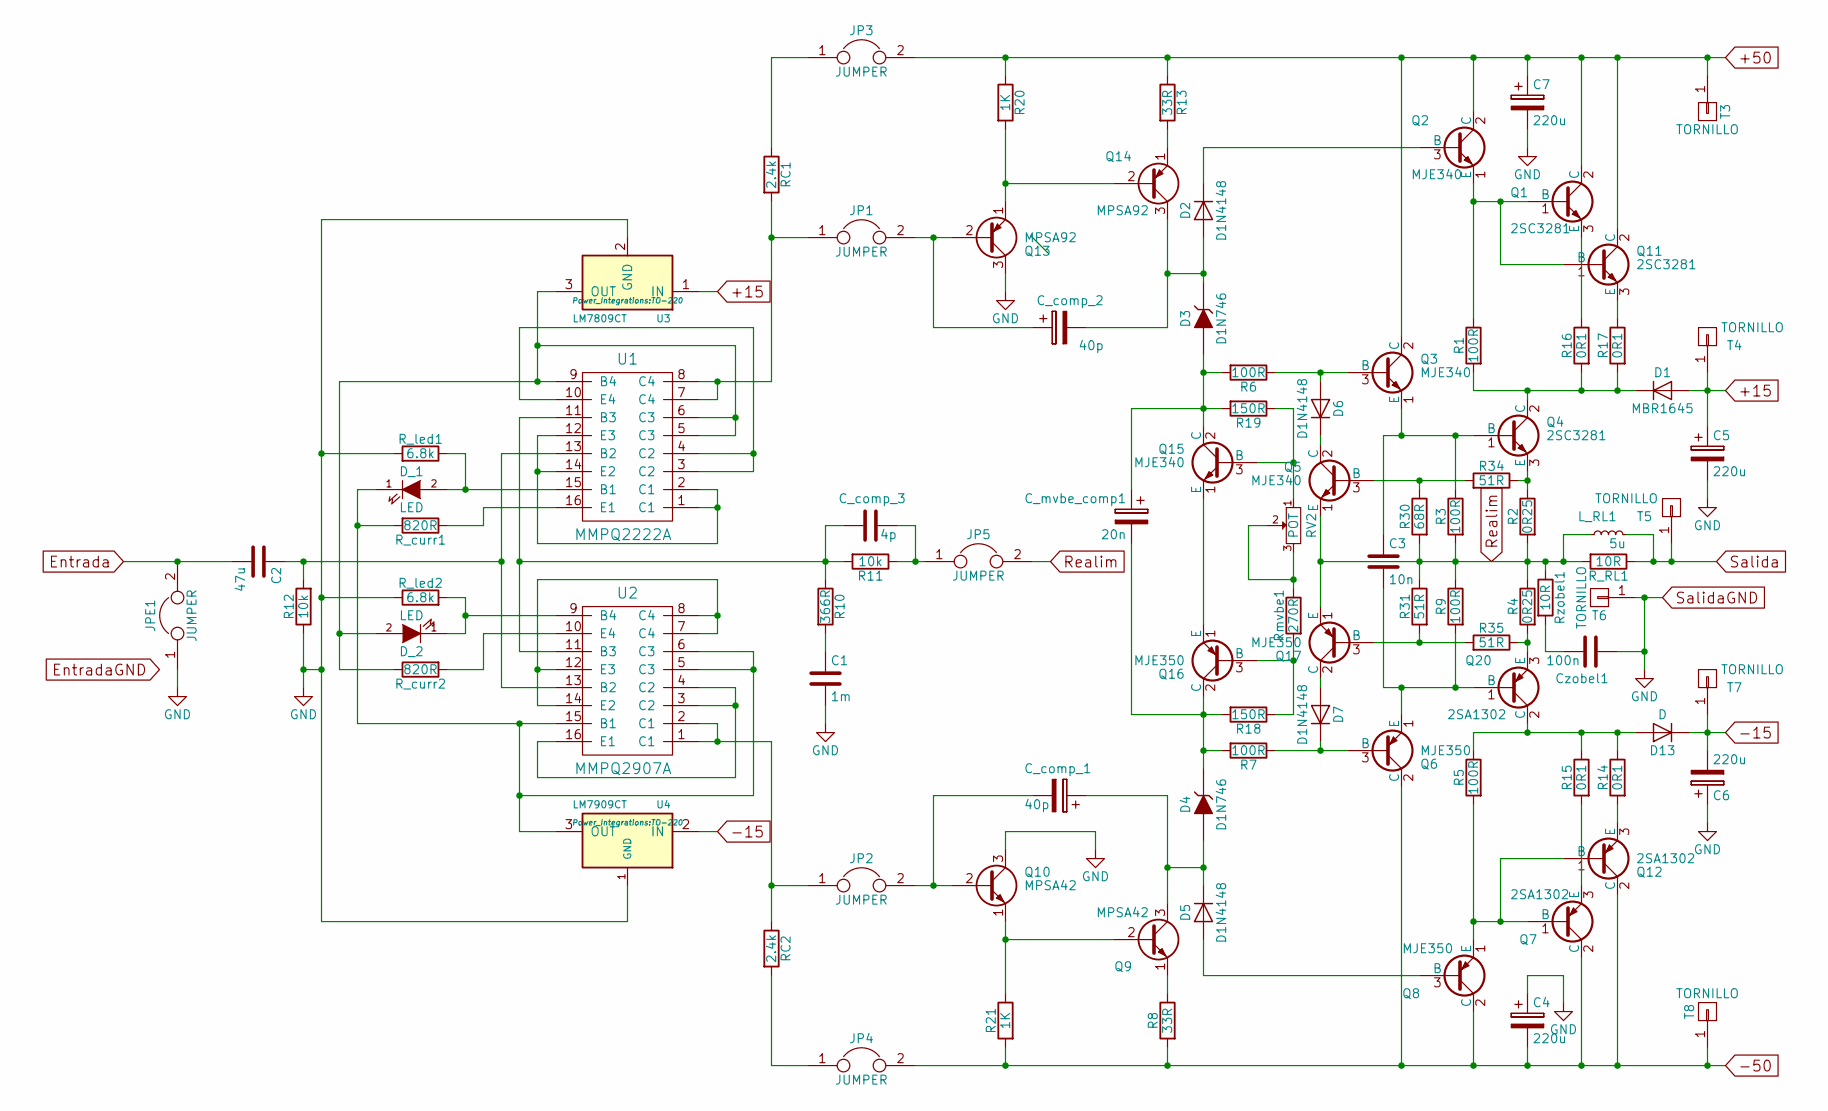
[picture p172: schematic amplificador.sch]

Parts:
C1: 1m; C_Rect_L7_W3.5_P5
C2: 47u; C_Rect_L7_W3.5_P5
C3: 10n; C_Rect_L7_W3.5_P5
C4, C5, C6, C7: 220u; CP5
C_comp_1, C_comp_2: 40p; CP5
C_comp_3: 4p; C_Rect_L7_W3.5_P5
C_mvbe_comp1: 20n; CP5
Czobel1: 100n; C_Rect_L7_W3.5_P5
D1: MBR1645; Diode_DO-41_SOD81_Horizontal_RM10
D2, D5, D6, D7: D1N4148; Diode_DO-35_SOD27_Horizontal_RM10
D3, D4: D1N746; Diode_DO-35_SOD27_Horizontal_RM10
D13: D; Diode_DO-41_SOD81_Horizontal_RM10
D_1, D_2: LED; LED-5MM
JP1, JP2, JP3, JP4, JP5: JUMPER; Pin_Header_Straight_1x02
JPE1: JUMPER; Pin_Header_Straight_1x02
L_RL1: 5u; CP4
Q1, Q4, Q11: 2SC3281; DT-25-B01W-03
Q2, Q3, Q5: MJE340; SOT126_SOT32_Housing_Vertical
Q6, Q8, Q17: MJE350; SOT126_SOT32_Housing_Vertical
Q7, Q12, Q20: 2SA1302; DT-25-B01W-03
Q9, Q10: MPSA42; TO-92_Inline_Narrow_Oval
Q13, Q14: MPSA92; TO-92_Inline_Narrow_Oval
Q15: MJE340; Bornera_Chica
Q16: MJE350; Bornera_Chica
R1, R3, R5, R6, R7, R9: 100R; Resistor_Horizontal_RM10mm
R2, R4: 0R25; Resistor_Ceramic_Horizontal_L36mm-W11mm-H10mm-p45mm
R8, R13: 33R; Resistor_Horizontal_RM10mm
R10: 366R; Resistor_Horizontal_RM10mm
R11, R12: 10k; Resistor_Horizontal_RM10mm
R14, R15, R16, R17: 0R1; Resistor_Ceramic_Horizontal_L36mm-W11mm-H10mm-p45mm
R18, R19: 150R; Resistor_Horizontal_RM10mm
R20, R21: 1K; Resistor_Horizontal_RM10mm
R30: 68R; Resistor_Horizontal_RM10mm
R31, R34, R35: 51R; Resistor_Horizontal_RM10mm
RC1, RC2: 2.4k; Resistor_Horizontal_RM10mm
RV2: POT; Potentiometer_Bourns_3296W_3-8Zoll_Inline_ScrewUp
R_RL1: 10R; Resistor_Horizontal_RM10mm
R_curr1, R_curr2: 820R; Resistor_Horizontal_RM10mm
R_led1, R_led2: 6.8k; Resistor_Horizontal_RM10mm
Rmvbe1: 270R; Resistor_Horizontal_RM10mm
Rzobel1: 10R; Resistor_Horizontal_RM10mm
T3, T4, T5, T6, T7, T8: TORNILLO
U1: MMPQ2222A; SOIC-16
U2: MMPQ2907A; SOIC-16
U3: LM7809CT; TO-220
U4: LM7909CT; TO-220

Connections:
+15: C5.1, D1.2 (A), T4.1, U3.1 (IN)
+50: C7.1, JP3.2, Q1.2 (C), Q2.2 (C), Q3.2 (C), Q11.2 (C), R13.1, R20.1, T3.1
-15: C6.2, D13.1 (K), T7.1, U4.2 (IN)
-50: C4.2, JP4.2, Q6.2 (C), Q7.2 (C), Q8.2 (C), Q12.2 (C), R8.2, R21.2, T8.1
Entrada: C2.2, JPE1.2
unnamed: C1.1, R10.2
unnamed: C2.1, R12.2, U1.13 (B2), U2.13 (B2)
unnamed: C3.1, Q3.1 (E), Q4.1 (B), R3.1
unnamed: C3.2, Q6.1 (E), Q20.1 (B), R9.2
unnamed: C_comp_1.1, D4.2 (A), D5.1 (K), Q9.3 (C)
unnamed: C_comp_1.2, JP2.2, Q10.2 (B)
unnamed: C_comp_2.1, JP1.2, Q13.2 (B)
unnamed: C_comp_2.2, D2.2 (A), D3.1 (K), Q14.3 (C)
unnamed: C_comp_3.1, R10.1, R11.2, U1.11 (B3), U2.11 (B3)
unnamed: C_comp_3.2, JP5.1, R11.1
unnamed: C_mvbe_comp1.1, D3.2 (A), Q15.2 (C), R6.2, R19.2
unnamed: C_mvbe_comp1.2, D4.1 (K), Q16.2 (C), R7.2, R18.2
unnamed: Czobel1.2, Rzobel1.2
unnamed: D1.1 (K), Q4.2 (C), R1.2, R16.2, R17.2
unnamed: D2.1 (K), Q2.3 (B)
unnamed: D5.2 (A), Q8.3 (B)
unnamed: D6.1 (K), Q5.2 (C)
unnamed: D6.2 (A), Q3.3 (B), R6.1
unnamed: D7.1 (K), Q6.3 (B), R7.1
unnamed: D7.2 (A), Q17.2 (C)
unnamed: D13.2 (A), Q20.2 (C), R5.1, R14.1, R15.1
unnamed: D_1.1 (K), R_curr1.2, U2.5 (C3), U2.6 (C3), U2.15 (B1), U4.3 (OUT)
unnamed: D_1.2 (A), R_led1.1, U1.15 (B1)
unnamed: D_2.1 (K), R_led2.2, U2.9 (B4)
unnamed: D_2.2 (A), R_curr2.1, U1.5 (C3), U1.6 (C3), U1.9 (B4), U3.3 (OUT)
unnamed: JP1.1, RC1.2, U1.7 (C4), U1.8 (C4)
unnamed: JP2.1, RC2.1, U2.1 (C1), U2.2 (C1)
unnamed: JP3.1, RC1.1
unnamed: JP4.1, RC2.2
unnamed: Q1.1 (B), Q2.1 (E), Q11.1 (B), R1.1
unnamed: Q1.3 (E), R16.1
unnamed: Q4.3 (E), R2.1, R34.1
unnamed: Q5.3 (B), R30.1, R34.2
unnamed: Q7.3 (E), R15.2
unnamed: Q9.1 (E), R8.1
unnamed: Q9.2 (B), Q10.1 (E), R21.1
unnamed: Q11.3 (E), R17.1
unnamed: Q7.1 (B), Q8.1 (E), Q12.1 (B), R5.2
unnamed: Q12.3 (E), R14.2
unnamed: Q13.1 (E), Q14.2 (B), R20.2
unnamed: Q14.1 (E), R13.2
unnamed: Q15.1 (E), Q16.1 (E)
unnamed: Q15.3 (B), R19.1, RV2.1
unnamed: Q16.3 (B), R18.1, Rmvbe1.2
unnamed: Q17.3 (B), R31.2, R35.2
unnamed: Q20.3 (E), R4.2, R35.1
unnamed: RV2.2, RV2.3, Rmvbe1.1
unnamed: R_curr1.1, U1.16 (E1)
unnamed: R_curr2.2, U2.10 (E4)
unnamed: U1.1 (C1), U1.2 (C1), U1.12 (E3), U1.14 (E2)
unnamed: U1.3 (C2), U1.4 (C2), U1.10 (E4)
unnamed: U2.7 (C4), U2.8 (C4), U2.12 (E3), U2.14 (E2)
unnamed: U2.3 (C2), U2.4 (C2), U2.16 (E1)
Realim: JP5.2, L_RL1.1, Q5.1 (E), Q17.1 (E), R2.2, R3.2, R4.1, R9.1, R30.2, R31.1, R_RL1.2, Rzobel1.1
Salida: L_RL1.2, R_RL1.1, T5.1
SalidaGND: C1.2, C4.1, C5.2, C6.1, C7.2, Czobel1.1, JPE1.1, Q10.3 (C), Q13.3 (C), R12.1, R_led1.2, R_led2.1, T6.1, U3.2 (GND), U4.1 (GND)

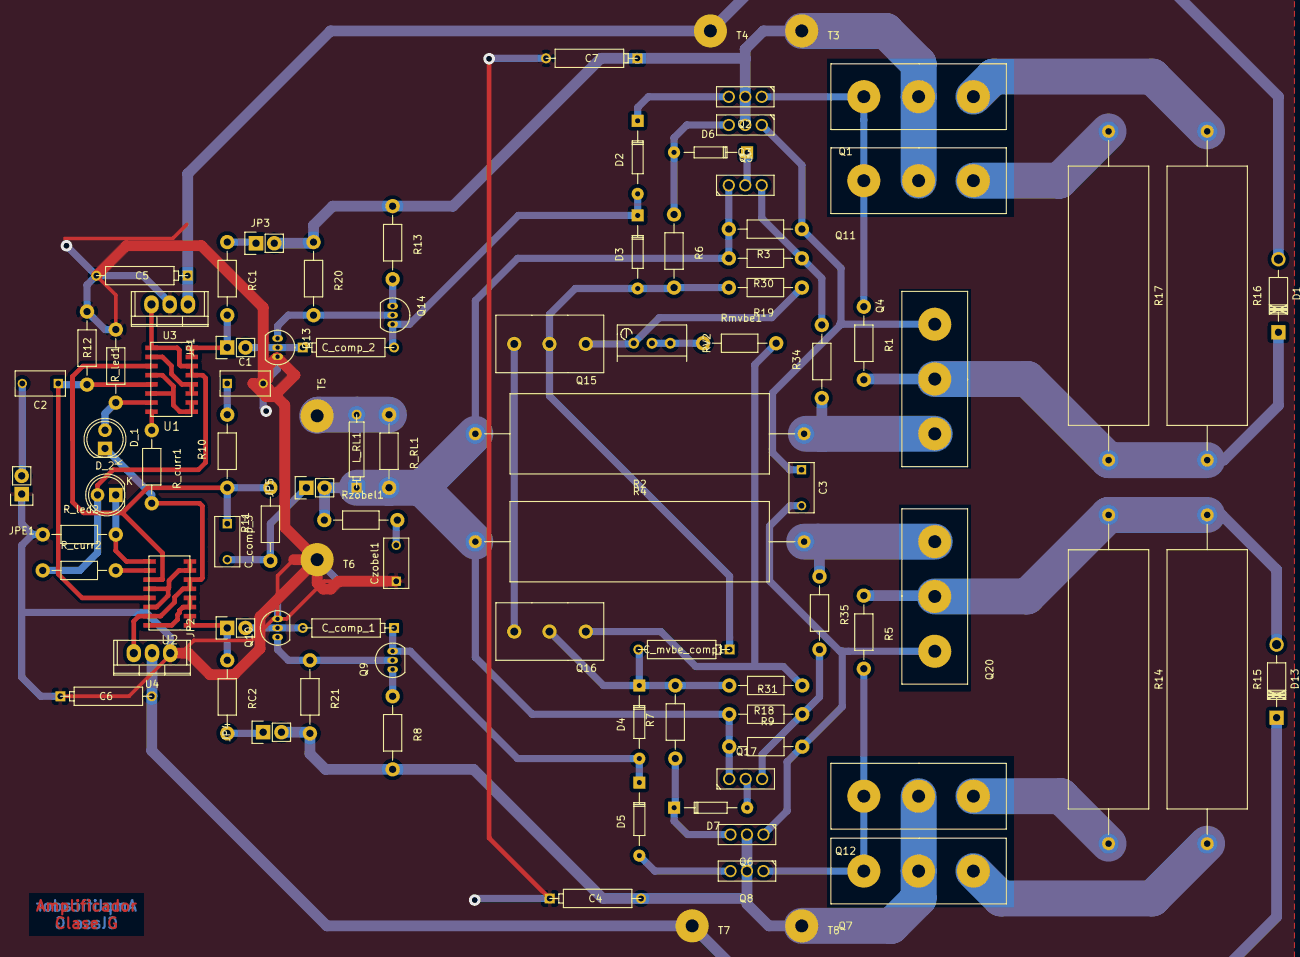
[picture p173: board amplificador.kicad_pcb from above]

Board: 2 copper layers, 92 parts (0 on the bottom side), 61 nets.
