nachocarballeda/gclass_amplifier/(commit log)

2015-04-29 Agrego archivos iniciales al repo.
    [amplificador_gclass.sch]
2015-05-08 cambio nombre de carpeta.
    [amplificador_gclass.sch]
2015-05-21 closes #1 , averiguados todos los transistores, esperando cotizacion de electronica liniers
2015-05-21 Creo esquematico en kicad del amplificador, falta arreglar un par de errores que tira GND , ya me habia pasado, preguntar que onda. Despues queda hacer bien el netlist sabiendo que componentes vamos 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
    [OPS.sch, amplificador_gclass_OPS.sch]
2015-05-22 Sigo con el fucking error de power conectors...
    [OPS.sch, amplificador_gclass.sch]
2015-05-22 Problema sobre power conections arreglado, ahora hay otros quilombos, creo que tiene que ver con el encapsulado de los transistores.
    [OPS.sch, amplificador_gclass.kicad_pcb, amplificador_gclass.sch]
2015-06-01 Sigo trabajando en el PCB usando Kicad, necesito mas info sobre los diodos para continuar.
    [OPS.sch, amplificador_gclass.sch]
2015-06-04 Agrego algunos datasheets, el export kicad en pdf y sigo trabajando en el PCB
    [OPS.sch, amplificador_gclass.kicad_pcb, amplificador_gclass.sch]
2015-06-05 Termino la primera version del PCB para el amplificador, queda engordar las pistas que llevan alta corriente.
    [OPS.sch, amplificador_gclass.kicad_pcb, amplificador_gclass.sch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]
2015-06-08 Arreglo problema, se mostraba cobre en el front , solo lo hice para Q1, queda hacerlo en todos y ajustar bien los drills, acorde a los que existen en el LCI...
    [OPS.sch, amplificador_gclass.kicad_pcb, amplificador_gclass.sch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]
2015-06-08 Cambio footprints, empiezo a re-rutear
    [OPS.sch, amplificador_gclass.kicad_pcb, amplificador_gclass.sch]
2015-06-09 nacho la soba
    [OPS.sch, amplificador_gclass.kicad_pcb, amplificador_gclass.sch]
2015-06-09 ultimos avances falta poco para terminar
    [OPS.sch, amplificador_gclass.kicad_pcb, amplificador_gclass.sch]
2015-06-10 pcb casi listo
    el pcb esta casi listo
    [OPS.sch, amplificador_gclass.kicad_pcb, amplificador_gclass.sch]
2015-06-10 doc de prueba
2015-06-10 agrando la mayoria de las pistas, alejo algunas pistas criticas del borde, exporto archivos de fabricacion.
    [amplificador_gclass-B_Cu.gbr, amplificador_gclass-Edge_Cuts.gbr, amplificador_gclass-F_Cu.gbr, amplificador_gclass.drl]
2015-06-10 Faltó cerrar el programa antes de pushear :P...
    [amplificador_gclass.kicad_pcb]
2015-06-11 exporto archivos para LCI
    [amplificador_gclass.drl]
2015-06-11 pcb terminado
    [$OPS.sch, $amplificador_gclass.sch, $file5578D375.sch, OPS.sch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]
2015-06-11 ahora si terminado
    [$OPS.sch, $amplificador_gclass.sch, $file5578D375.sch, OPS.sch, amplificador_gclass.sch]
2015-06-22 Arreglando PCB
    [OPS.sch, amplificador_gclass.kicad_pcb, amplificador_gclass.sch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]
2015-06-22 Cambio las fuentes de corrientes por unas mas estables, agrando todas las pistas, agrego mini planos de tension para potencia, cambio pines de salida.
    [$amplificador_gclass.sch, OPS.sch, amplificador_gclass.kicad_pcb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]
2015-06-22 Arreglo un par de cositas mas, creo que con esto ya etsamos.
    [amplificador_gclass.kicad_pcb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]
2015-06-22 Agrego nuevos edges.
    [amplificador_gclass-Edge_Cuts.gbr]
2015-06-22 cambios minimos.
    [$amplificador_gclass.sch, amplificador_gclass.kicad_pcb, amplificador_gclass.sch]
2015-06-23 Agrando mucho mas las pistas, agrego pin de entrada, muevo diodo zener
    [amplificador_gclass.kicad_pcb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]
2015-06-23 Pistas MAS grandes, export archivos, arreglo pequeños defectos
    [amplificador_gclass.kicad_pcb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]
2015-06-24 pcb disipadores
    [pcb transistores.kicad_pcb, pcb transistores.sch, pcb transistores2.kicad_pcb, pcb transistores2.sch]
2015-07-02 algun cambio
    [amplificador_gclass.kicad_pcb, amplificador_gclass.sch]
2015-07-03 agrego simulacion de error
2015-10-26 Agrego todo lo que tenia del informe en sharelatex.
2015-11-07 subo el pdf del informe para que lo pueda ver Fede, y muevo modelos
2015-11-08 agrego simulaciones
    agrego varias simulaciones del circuito final con la configuracion de
    entrada con doble par diferencial y tension de +/- 15V
2015-11-08 cambie los nombres de los archivos
2015-11-30 Trabajando con THS4532
    Agrego Footprint y model hecho a mano del THS.
    Agrego modelo Spice THS (ver si funca).
    Agrego el informe main.pdf asi Fede lo puede ver.
    [THS4532.DSN, THS4532.OLB, THS4532.opj, amplificador_gclass.sch]
2015-11-30 Ordenando Repo
    Renombro carpetas que contenian espacio.
    Muevo carpetas a donde corresponden.
    PCB.PRETTY queda en su lugar para evitar problemas con rutas KiCad.
    [pcb transistores.kicad_pcb, pcb transistores.sch, pcb transistores2.kicad_pcb, pcb transistores2.sch]
2015-11-30 Limpio, agrego cosas
    Agrego carpeta aparte para ampli usando THS.
    Agrego datasheet de THS4532.
    Odeno capeta simulaciones.
    [$gclass_with_THS.sch, amplificador_gclass.sch]
2015-11-30 Agrego simulacion y pdf
    Agrego primera simulacion del modulo THS4532 de Texas. La misma usa un modelo hecho por la gente de TI.
    Agrego documento de TI que trata sobre amplificadores diferenciales.
2015-11-30 Arranco sch para full diff
    [gclass_with_THS.sch]
2015-11-30 Trabajando con THS4532
    Agregada simulacion que prueba integrado. (success)
    Agregada simulacion que prueba GCLASS with THS. No puede simular, tarda mucho.
    [gclass_with_THS.sch]
2015-12-03 Apenas empezado el informe, puse los puntos y a escribir.
2015-12-03 Verifiqué las simulaciones, la posta es el Clase G par doble +15-15.asc
2015-12-04 Avance con el informe de avance, falta agregar a Rui, y su padrón.
    Falta un punto que no entendí que es lo que quiere que pongamos, y estaría bueno que lean revisen opinen y modifiquen.
2015-12-04 Argegado rui a la caratula
2015-12-04 agregue fiuba.pdf para que compile
2015-12-04 Agregue pdf de la charla de diseño de circuitos integrados, por si nos ayuda a entender que quieren del informe de avance
2015-12-04 Agregué el último diseño del circuito en el directorio "impreso"
    [amplificador.kicad_pcb, amplificador.sch]
2015-12-04 Agregue pdf que explica lo que hay que chamullar. VERLO
2015-12-04 un par de notebooks que use para hacer cuentitas
2015-12-05 1er informe de avance
2015-12-07 resistencias in y out
2015-12-09 circuito que mandó por mail Fede
2015-12-09 baje a 71.5 las re de vas
2015-12-09 nuevos graficos de barridos de r_out con fuente de corriente a la salida
2015-12-11 no creo haber cambiado nada en el informe pero git dice que sí, así que acá va commit
2015-12-11 cosas de rui
2015-12-11 circuito de doble emisor común como vas que sugirio fede
2015-12-11 mas de lo mismo
2015-12-11 Calculo de disipadores
    Falta poner un chamuyo de como se calcula el caso de maxima disipacion, preguntar que pasa con varios transistores en un mismo disipador y ver porque da negativo el calculo para la parte interna de la etapa de salida.
2015-12-11 circuitos para el 2do informe de avance
2015-12-11 un poco de informe de avance
2015-12-12 correciones fede
    Agrego simulacion con correcciones de fede.
    Edito TODO.
2015-12-13 New Components & Footprints
2015-12-13 Agregado el amplificador final para el informe
    Este es un mensaje descriptivo.
    En esta oportunidad, les vengo a ofrecer un archivo de LTSpice,
    extensión asc, que conjuga el fruto de nuestros esfuerzos hasta la
    fecha, menos nuestros olvidos y errores. Sin esos subcircuitos tan
    odiados por Iván, esta versión ofrece una distorsión 4 veces mayor a la
    especificada, culpa de una pérdida importante de ganancia de lazo en la
    primera etapa al implementar las modificaciones propuestas por Fede.
    Dediqué horas y horas en un camino alternativo, que fue muy difícil de
    compensar, pero cuando finalmente lo logré, percibí que estaba simulando
    el slew rate de otro circuito, y el de ese era una PO-RO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
2015-12-14 Terminado el esquemático armado a partir de ampli-exp.asc, empiezo el PCB.
    [amplificador.sch]
2015-12-14 Regenerados los gráficos del informe de avance
    Regenerados los gráficos que ya había y alguna cosita más. Pero,
    faltaría en grueso de las cosas que nunca hubo, pero me parece que es
    poca cosa. En particular, no hay nada escrito respecto del diseño del
    circuito, salvo el resultado final.
    También, se agrega un .mod con los modelos de spice que me había
    olvidado de subir, y algunos datos sacados de ltspice de simulaciones.
2015-12-14 Agrego info al asc
    Esto es para facilitar un posible debug. Saludos para anojo.
2015-12-14 Esta casi listo el PCB, necesito ayuda, ensanchen las pistas de potencia, pongan un plano de masa atrás, para vincular todos los componentes que falta mandar a masa, y hacen falta un par de vías.
    Con más tiempo, lo dejaría mejor, pero es un quilombo. Tendría que comparar como hice la vez pasada, que me quedó de re chupete.
    [amplificador.kicad_pcb, amplificador.sch]
2015-12-14 Avances en el informe
    Chamullos de compensación y diseño de las primeras
    2 etapas. También, simulaciones de ganancia de estas etapas.
    Fixes #20
2015-12-14 Terminé la versión 0.1 del PCB. Listo? Aprobamos el informe de avance?
    [amplificador.kicad_pcb]
2015-12-15 Agregando exports de PCB
    ya casi estamos.
2015-12-15 Selecciono y agrego fotos de los disipadores
2015-12-15 Agrego diagrama de bloques by anojo
2015-12-15 Final de cursada
2015-12-16 Agregué la Red de Zobel.
    [amplificador.kicad_pcb, amplificador.sch]
2015-12-16 Agregué el punto de Red de Zobel en el informe.
2015-12-16 Agrego BOM, script que la genera y tutorial
2015-12-16 BOM: digo cuales son SMD, queda definir segundo disipador
2015-12-16 Arreglo disipadores. pongo ZD14
    tambien edito lista de componentes..
2015-12-16 Teminamos la BOM
    closes #17
2015-12-16 elimino lo que se dijo del clase D
2015-12-16 Exporto el nuevo PCB y lo pongo en el tex
    Y ahi va otro issue.
    closes #18
2015-12-16 Agrego materiales de las cosas
2015-12-16 Edito Tex
    Agrego cosas a realizar en febrero y datos de fuente conmnutada
2015-12-16 Trabajando en integracion
    Armo diagramas de coneccionado completo e interno.
    Agrego modelo 3D del PCB para futuras imagenes de integracion con mas realismo.
    [PCB_3d_model.fcstd]
2015-12-17 Agregué texto a la descripción de las etapas, especificando los motivos de la elección de las distintas opciones de diseño.
2015-12-17 meto chamuyo de integracion
2015-12-17 Agregué la explicación de la realimentacion por bloques.
2015-12-17 Capacitancias en cables
    Meto chamuyo, tiro footnote al paper.
    Pongo imagen de cable trenzado forrado que es la posta.
    Explico que somos muy grosos haciendo PCBs.
2015-12-17 Agregué resistencias de emisor, y resistencia a la salida. No pude agregar inductor, no lo encuentro en las bibliotecas.
    [amplificador.kicad_pcb, amplificador.sch]
2015-12-17 Agregué el texto como pidio Nachito.
2015-12-17 un poco de un par de cosas
2015-12-17 Agregué el separador de capacitancia de carga al esquemático y al PCB.
    [amplificador.kicad_pcb, amplificador.sch]
2015-12-17 el circuito nuevo
2015-12-17 Redes de Salida
    Red zobel + R-L
    Chamuyo, simulacion y mas.
2015-12-17 Agregué el diagrama de compensación ideal, y un poco de texto.
2015-12-17 Expliqué porqué usamos las fuentes de corriente que usamos, y los reguladores de 9V.
2015-12-17 Agregué cómo calcular el Slew-Rate, Bertu-Style.
2015-12-17 Ordeno y limpio Repo
    [$gclass_with_THS.sch, OPS.sch, PCB_3d_model.fcstd, amplificador.kicad_pcb, amplificador.sch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]
2016-03-15 Cambiando modelos transistores entrada
    Ahora los transistores de la simulacion son los que vamos a utilizar (integrados)
    closes #44
2016-04-19 Revert "Ordeno y limpio Repo"
    This reverts commit d58d696824c45bbce0f2da3025cfa9f12b55e583.
    [$gclass_with_THS.sch, OPS.sch, PCB_3d_model.fcstd, amplificador.kicad_pcb, amplificador.sch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]
2016-05-10 Modifiqué los transistores de la etapa diferencial. Última versión: ampli-exp.asc
2016-06-13 Agregué 2 archivos de simulaciones, en los que probamos las protecciones para el circuito.
    [_saved_amplificador.sch]
2016-07-01 agrego documento copado de protecciones
2016-09-23 Se hizo el ruteo con los nuevos componentes, y se corrigieron los valores de las protecciones, corrigiendo las disparidades.
    Ya se mandó el circuito al LCI, para hacer.
    [amplificador.kicad_pcb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]
2017-02-20 Ensanché las vías del PCB y agregué un par de vías.
    [amplificador.kicad_pcb, amplificador.sch]
2017-07-27 Minor changes
    *KiCad BRD file: A fucking component's label was moved in ordeer to allow a better understanding of the board.
    *Ampli-exp.asc & primera-etapa.asc Power sources +12/-12 replace old & stupid voltage divider.
    [amplificador.kicad_pcb]
